wiktorCzechowski8127/MilitaryGamesTimer/media/doc_media/doc1_download.jpg

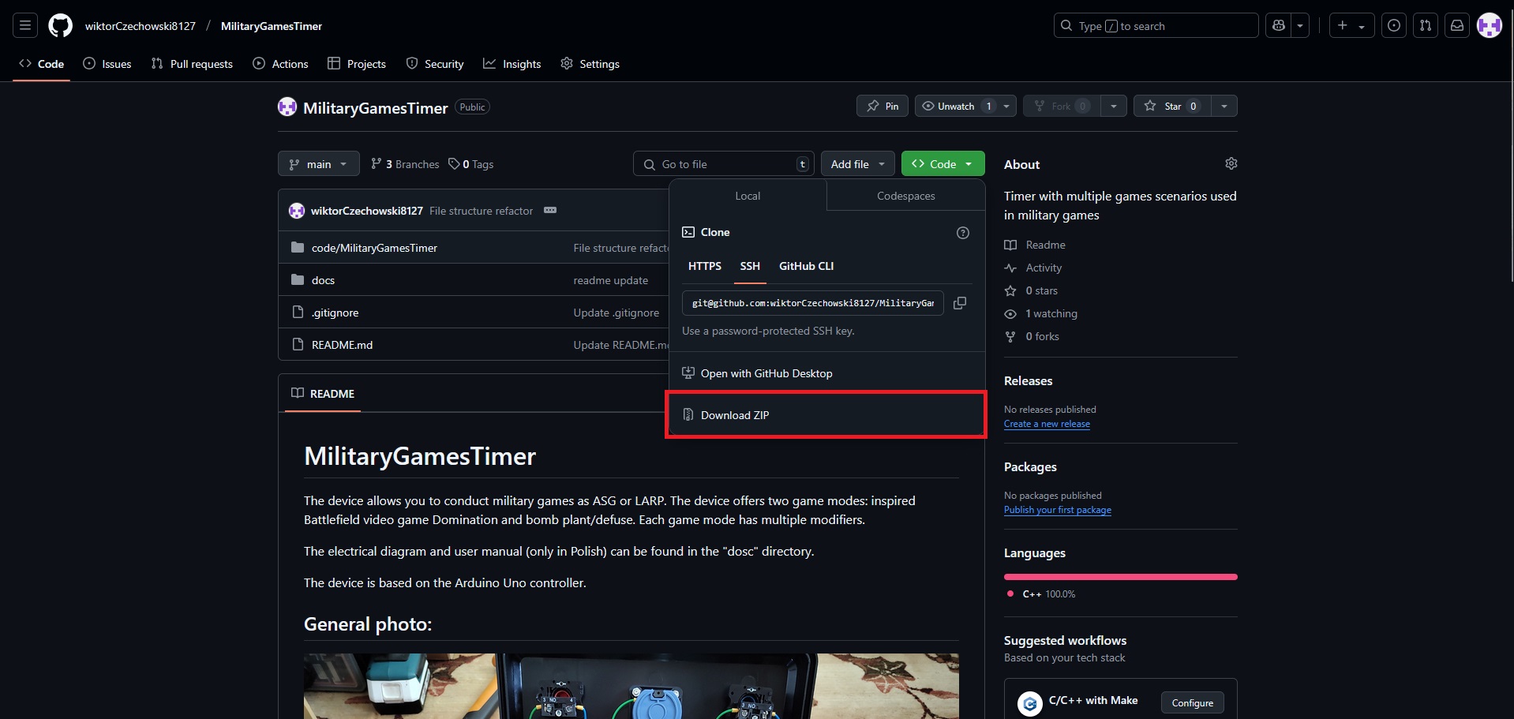
media/doc_media/doc1_download.jpg
