wiktorCzechowski8127/MilitaryGamesTimer/media/doc_media/doc2_idePresentation.jpg

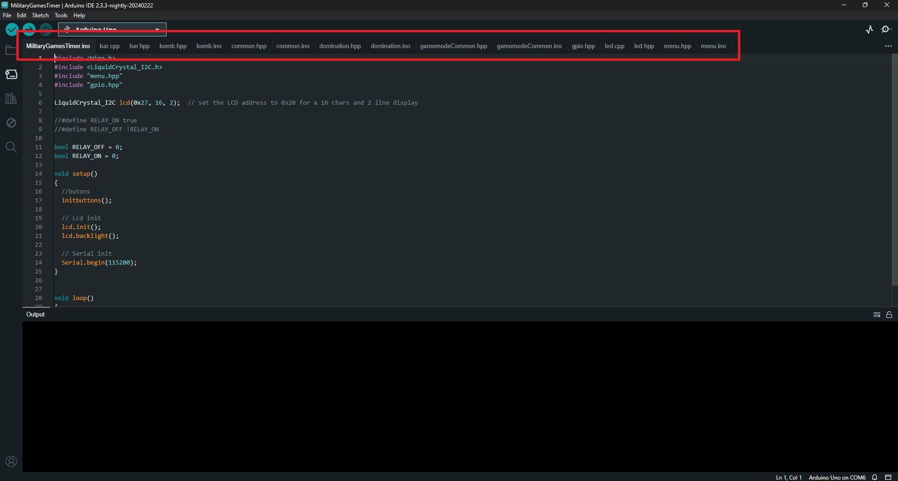
media/doc_media/doc2_idePresentation.jpg
