wiktorCzechowski8127/MilitaryGamesTimer/media/doc_media/doc3_boardSelection.jpg

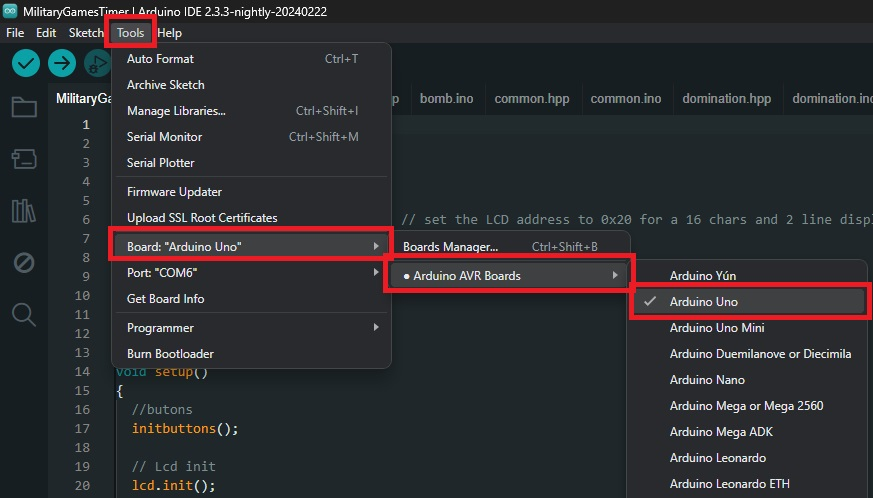
media/doc_media/doc3_boardSelection.jpg
