wiktorCzechowski8127/MilitaryGamesTimer/media/doc_media/doc4_portSelection.jpg

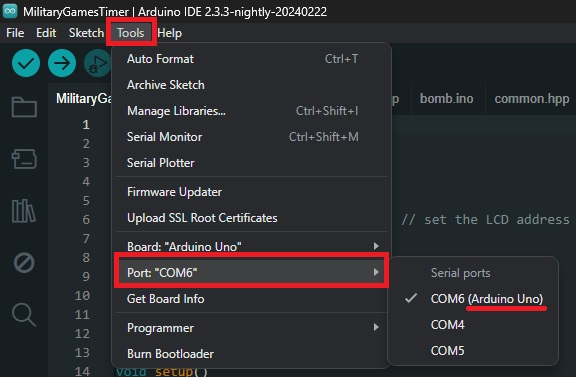
media/doc_media/doc4_portSelection.jpg
