wiktorCzechowski8127/MilitaryGamesTimer/media/doc_media/doc5_upload.jpg

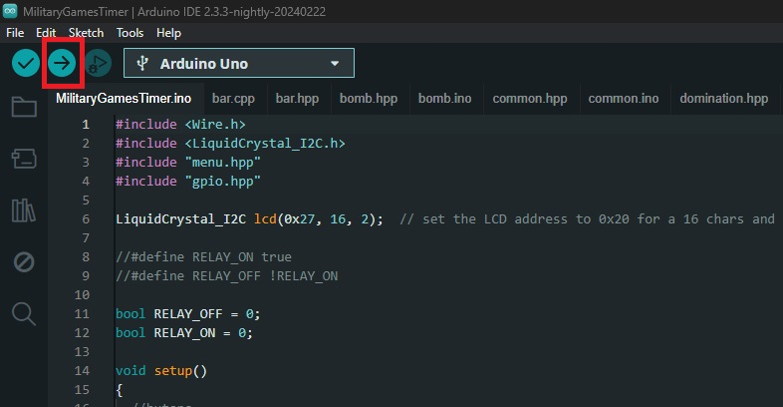
media/doc_media/doc5_upload.jpg
