wiktorCzechowski8127/MilitaryGamesTimer/media/doc_media/doc6_final.jpg

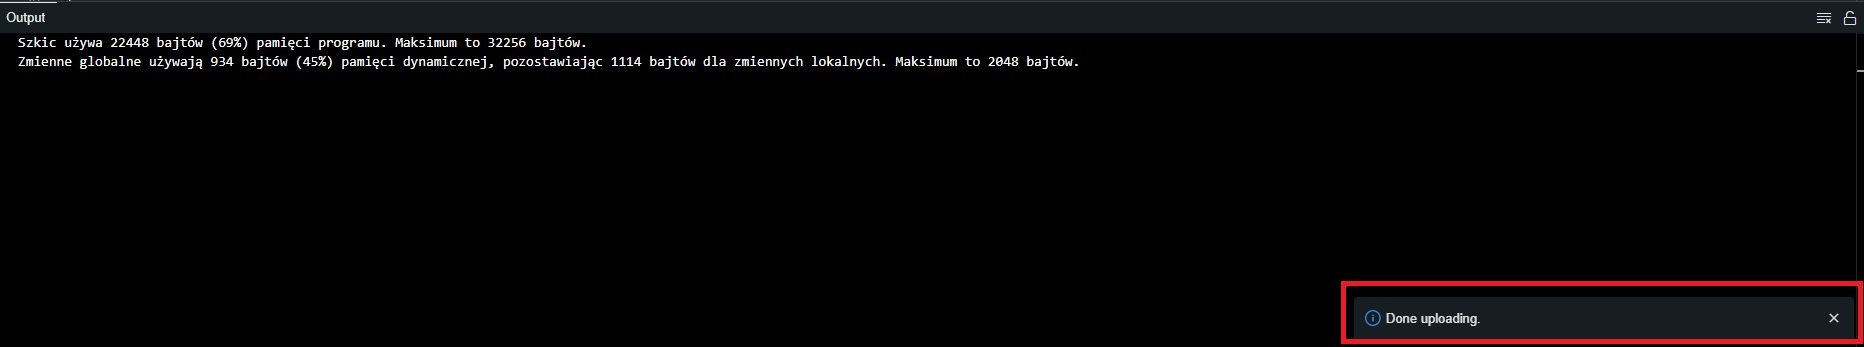
media/doc_media/doc6_final.jpg
