wiktorCzechowski8127/MilitaryGamesTimer/docs/MilitaryGameTimerInstructionPL.pdf

Ostatnia modyfikacja 09.02.2025

# MASZYNA LICZĄCA DO GIER MILITARNYCH

## Autor: Wiktor Czechowski

email: wiktor.czechowski.ti@gmail.com

github: https://github.com/wiktorCzechowski8127/MilitaryGamesTimer
Link do pobrania programu: LINK (https://github.com/wiktorCzechowski8127/MilitaryGamesTimer/archive/refs/heads/main.zip)

### Aktualna wersja dokumentacji nie posiada opisu funkcji

opóźnionego startu, aktualizacja w trakcie przygotowań.

# 1. Uwagi

Jeżeli syrena odziała od momentu uruchomienia układu, należy zewrzeć styki A0 i A1 sterownika i zresetować urządzenia. Więcej informacji w akapicie: Przekaźnik.

# 2. Sugerowane komponenty

Podane linki stanowią jedynie sugestię w jakie komponenty należy się zaopatrzyć. Możliwe jest dowolna zmiana podzespołów pod warunkiem, że działają w tym samym standardzie. Przyciski i przełączniki mogą przybierać różne formy.

Lp. | Nazwa | Komentarz | Link
1. | Arduino Uno R3 | Kupno “klona” arduino pozwoli mocno zredukować koszty. Klony nie naruszają licencji, niektóre marki jak DFRobot oferują jakość oryginału lepszej cenie. Najtańsze chińskie klony często mają nierówno przylutowane porty jednak swoim działaniem nie różnią się od oryginału. W przypadku chińskich klonów odradzam kupowania produktów z konwerterem CH340. Układ ten ma problem z kompatybilnością z Arduino IDE i wgranie programu na sterownik, może wymagać zainstalowania sterowników z zewnętrznych źródeł. Gwarancją poprawnego działania będzie sterownik z konwerterem opartym na układzie Atmel Mega16U2. | Oryginalne arduino (https://botland.com.pl/arduino-seria-podstawowa-oryginalne-plytki/1060-arduino-uno-rev3-a000066-7630049200050.html) Droższy klon bardzo dobrej jakości (https://botland.com.pl/plytki-zgodne-z-arduino-dfrobot/2683-dfrduino-uno-v3-kompatybilny-z-arduino-6959420900015.html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) Tani klon (https://nettigo.pl/products/klon-arduino-uno-r3-atmega328p-mega16u2)
2. | Bateria | Bateria o napięciu wyjściowym 7-12V. | Link (https://botland.com.pl/akumulatory-li-pol-3s-111v-/1307-pakiet-li-pol-redox-700mah-20c-3s-111v-5903754000454.html)
3. | Stabilizator liniowy | Min. 250 mA maksymalnego prądu, zalecane 1A. | Link (https://botland.com.pl/regulatory-napiecia/81-stabilizator-5v-l7805abv-tht-to220-5904422307202.html)
4. Wyświetlacz Lcd | 16x2 | Sterownik zgodny z HD44780 | Wersja bez konwertera (https://botland.com.pl/wyswietlacze-alfanumeryczne-i-graficzne/19732-wyswietlacz-lcd-2x16-znakow-niebieski-ze-zlaczami-justpi-5903351243131.html) Wersja z konwerterem (https://botland.com.pl/wyswietlacze-alfanumeryczne-i-graficzne/2351-wyswietlacz-lcd-2x16-znakow-niebieski-konwerter-i2c-lcm1602-5904422309244.html)
5. Konwerter I2C do | wyświetlacza lcd | Dostępne są wyświetlacze lcd z wlutowanym konwerterem i2c. | Link (https://botland.com.pl/konwertery-pozostale/2352-konwerter-i2c-dla-wyswietlacza-lcd-hd44780-5903351248693.html)
6. | Moduł przekaźnika | Należy upewnić się czy moduł zwiera styki wejścia “NO” gdy na pin “In” podawany jest stan wysoki czy stan niski. Obydwa rodzaje przekaźników będą działały poprawnie jednak w wypadku tego drugiego konieczne będzie zwarcie ze sobą pinów A0 i A1 sterownika. | Link (https://botland.com.pl/przekazniki-przekazniki-arduino/8463-modul-przekaznika-1-kanal-styki-10a250vac-cewka-5v-5904422300517.html)
7. Przełącznik | dźwigniowy | Dostępne jest wiele modeli. | Link (https://electro24.pl/Lacznik-Krzywkowy-16A-0-1-1F-Tablicowy-Ip65)
8. | Przyciski NO | Dostępne jest wiele modeli. Najczęściej duże, czerwone przyciski sterownicze są przyciskami NC które nie będą poprawnie współpracowały z urządzeniem. | Przyciski gry (https://electro24.pl/pl/p/Przycisk-Sterowniczy-Niebieski-Xb2-Ea61-Fi22/8545) Przyciski menu (https://botland.com.pl/tact-switch/11197-tact-switch-12x12mm-z-nasadka-grzybek-zolty-5szt-5904422307516.html)

| | Sugerowany produkt posiada wymienny moduł: LINK. (https://electro24.pl/Styk-Pomocniczy-Zwierny-No-Xb2-Be101-Zielony)
9. | Diody led | Do prawidłowego podłączenia diod potrzebne będą 2 rezystory 50 i 100 ohm. | Link (https://botland.com.pl/diody-led/19991-dioda-led-5mm-niebieska-10szt-justpi-5904422328795.html)
10. | Buzzer | Wymagane napięcie zasilania 5V. | Link (https://botland.com.pl/buzzery-generatory-dzwieku/786-buzzer-z-generatorem-5v-12mm-tht-5904422366940.html)
11. | Syrena | Napięcie zasilania dostosowane do posiadanej baterii. Zalecane 7-12V. | Link (https://botland.com.pl/syreny-alarmowe/3040-syrena-alarmowa-s2-6-14v-105db-6-tonow-5900804011804.html)

Ostatni dostęp: 23.04.2024

# 3. Schemat elektryczny

Schemat w wyższej rozdzielczości dostępny pod linkiem: LINK. (https://github.com/wiktorCzechowski8127/MilitaryGamesTimer/tree/main/docs)

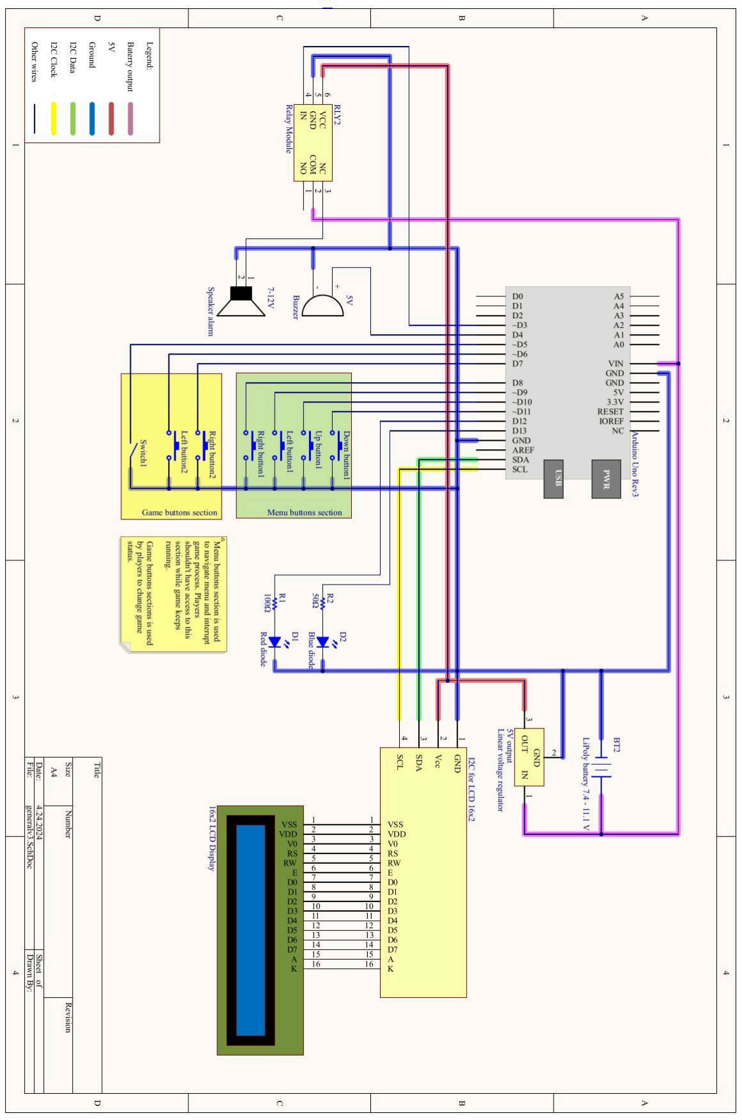
[picture p8: figure]

# 4. Opis oprogramowania

## 4.1. Opis manipulatorów

### - Nawigacja w menu

Nawigacja w menu odbywa się za pomocą 4 przycisków.

Nawigacja w ramach funkcji: Ustaw czas, Ustaw wartość jest nieco inna, szczegóły w opisie poszczególnych funkcji.

### - Sterowanie w grze

Sterowanie w grze odbywa się za pomocą dwóch przycisków, przełącznika oraz dwóch przycisków menu pełniących rolę moderatorskie.

Pin sterownika | Przycisk nawigacji | Funkcja
D8 | MENU_PRAWO | Następna opcja
D9 | MENU_LEWO | Poprzednia opcja
D10 | MENU_GÓRA | Powrót
D11 | MENU_DÓŁ | Akceptacja
Pin sterownika | Przycisk gry | Funkcja
D7 | GRA_PRAWY | Przejmowanie punktu (więcej szczegółów w opisach poszczególnych trybów gry).
D6 | GRA_LEWY | Przejmowanie punktu (więcej szczegółów w opisach poszczególnych trybów gry).
D5 | GRA_PRZEŁĄCZ NIK | Blokada pozostałych przycisków gry (opcjonalne).
D8 - D9 | MENU_PRAWO oraz MENU_LEWO | Naciśnięcie i przytrzymanie tych przycisków przez 3 sekundy powoduje: ● Zakończenie gry ● Wyłączenie syreny po zakończeniu gry ● Wyjście z podsumowania gry do menu Gracze nie powinni mieć dostępu do tych przycisków w trakcie rozgrywki.

## 4.2. Wybór trybu gry - menu etap 1

Lp. | Tryb gry | Opis
1. | Bomba | Uzbrojenie bomby zanim przybędą posiłki i utrzymanie bomby przez czas potrzeby do inicjalizacji wybuchu.
2. | Dominacja | Przejęcie i utrzymanie punktu.

Użycie przycisków MENU_PRAWO i MENU_LEWO pozwala wybrać tryb gry. Przycisk MENU_DÓŁ przenosi do menu związanego z wybranym trybem gry.

## 4.3. Tryby rozgrywki - menu etap 2

### 4.3.1. Tryb bomby

- Opis rozgrywki
Ilość drużyn: 2 (broniąca, atakująca)
Celem drużyny broniącej niedopuszczenie do uzbrojenia bomby przez czas zdefiniowany w polu CZAS GRY. Jeżeli po zakończeniu tego czasu bomba pozostanie nieuzbrojona, wygrywa drużyna broniąca. Jeżeli po zakończeniu tego czasu bomba będzie uzbrojona gra kończy się dopiero w momencie doprowadzenia do wybuch lub rozbrojenu bomby.
Celem drużyny atakującej jest uzbrojenie bomby oraz utrzymanie tego stanu przez CZAS WYBUCHU. Jeżeli po zakończeniu tego czasu bomba pozostanie uzbrojona, wygrywa drużyna atakująca.
Uzbrajanie i rozbrajanie bomby odbywa się poprzez naciśnięcie i przytrzymanie GRA_PRAWY i GRA_LEWY przycisku gry przez czas określany jako UZBRAJANIE lub ROZBRAJANIE.
- Dostępne modyfikatory
Lp. | Pozycja | Funkcja | Opis | Limity
1. | CZAS GRY | Ustaw czas | Czas do przybycia posiłków. Ustawienie czasu jako 0 spowoduje usunięcie z gry motywu przybycia posiłków.
2. CZAS | WYBUCHU | Ustaw czas | Czas do wybuchu bomby.
3. | UZBRAJANIE | Ustaw czas | Czas potrzebny do uzbrojenia bomby.

4. | ROZBRAJANIE | Ustaw czas | Czas potrzebny do rozbrojenia bomby.
5. | PRZEŁĄCZNIK | TAK/NIE | TAK: Ustawienie GRA_PRZEŁĄCZNIK w pozycji “0” blokuje możliwość korzystania z przycisków gry. NIE: Pozycja GRA_PRZEŁĄCZNIK nie ma wpływu działanie przycisków gry.
6. ROZ. KONCZY | (Rozbrojenie kończy grę) | TAK/NIE | Pierwsze rozbrojenie kończy grę z drużyną broniącą jako zwycięzca.
7. RES.CZAS.EK | S (Reset czasu eksplozji) | TAK/NIE | Czas potrzebny do wybuchu po każdym uzbrojeniu liczony jest od nowa.
8. COFANIE | PROG. (Cofanie progresu) | TAK/NIE | Zaprzestanie uzbrajania lub rozbrajania powoduje cofanie progresu operacji w identycznym tempie.
9. | SYRENA | Ustaw czas | Długość działania syrenu po zakońćzeniu gry.
10. | HISTORIA | Historia | Wyświetlanie wyników 3 ostatnich rozgrywek.
11. | Start | Start | Naciśnięcie i przytrzymanie przez 3 sekundy przycisku MENU_DÓŁ uruchamia wybrany tryb gry.

- Interfejs gry

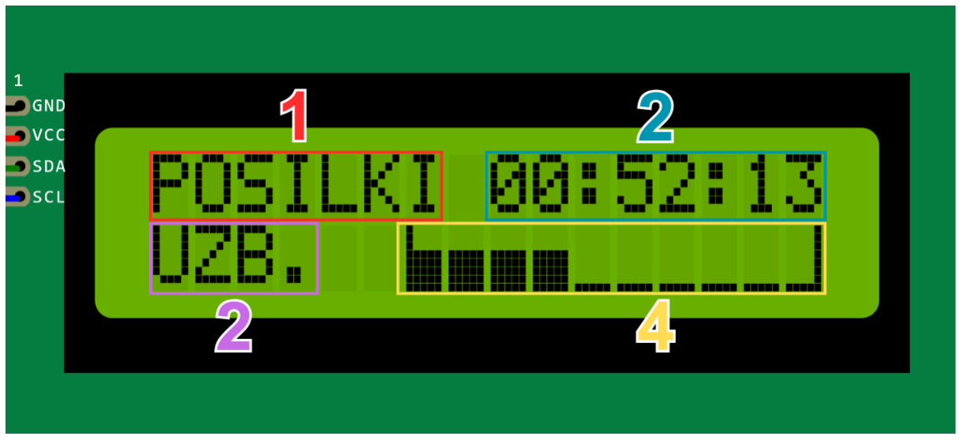
[picture p9: figure]

1. Aktualny status zegara.
POSIŁKI - czas przybycia posiłków WYBUCH - czas do wybuchu bomby.
2. Czas do wystąpienia akcji opisanej w punkcie 1.
3. Aktualnie wykonywana operacja na bombie: UZB. - uzbrajanie,
ROZ. - rozbrajanie.
4. Progress wykonywanej operacji.
- Sygnały świetlne
Led | Sposób działania | Informacja
Czerwony | Praca ciągła | Bomba uzbrojona.
| Mruganie | Uzbrajanie bomby.
Niebieski | Praca ciągła | Bomba rozbrojona.
| Mruganie | Rozbrajanie bomby.

- Podsumowanie

Po zakończeniu rozgrywki wyświetlone zostanie podsumowanie:

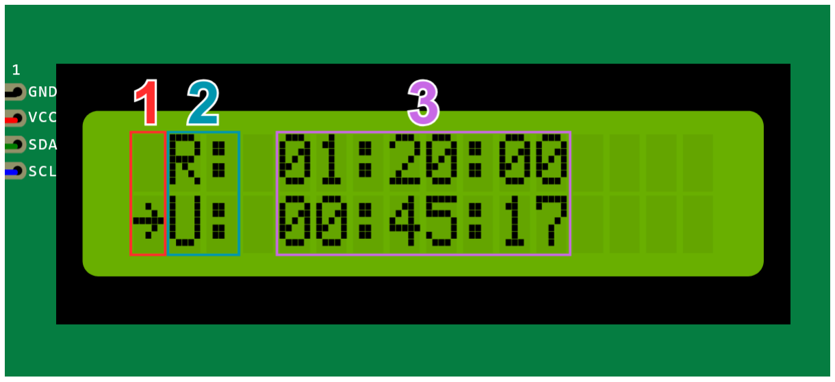
[picture p10: figure]

1. Oznaczenie wygranej: strzałka wskazuje na drużynę, która wygrała.
2. Oznaczenie statusu bomby:
R - Rozbrojona,
U - Uzbrojona.
3. Łączny czas statusu jaki posiadała bomba w trakcie całej rozgrywki.

### 4.3.2. Tryb dominacji

- Opis rozgrywki
Ilość drużyn: 2 (atakująca, atakująca)
Tryb gry wzorowany na trybie “Dominacja” występującym w grach z serii Battlefield. Celem każdej z drużyn jest zdobycie i utrzymanie punktu. Przejmowanie punktu odbywa się za pomocą naciśnięcia i przytrzymanie przez czas określony w parametrach PRZEJECIE i P.PRZEJECIE, przycisku (w zależności od podziału drużyn) GRA_LEWY lub GRA_PRAWY. Posiadanie punkt przez czas określony w parametrze PUNKT CO generuje punkt zwycięstwa.
Zdobycie przez którąś z drużyn punktów zwycięstwa w liczbie określonej przez parametr LIMIT PKT kończy grę. Alternatywnym zakończeniem gry jest upływ czasu CZAS GRY, zwyciężą wtedy drużyna posiadająca większą ilość punktów zwycięstwa.
- Dostępne modyfikatory
Lp. | Pozycja | Funkcja | Opis | Limity
1. | CZAS GRY | Ustaw czas | Maksymalny czas gry. Ustawienie wartości 0 uruchomi grę w trybie nielimitowanego czasu. Zegar będzie wyświetlał czas który upłynął od startu.
2. P. PRZEJECIE | (Pełne przejęcie) | Ustaw czas | Maksymalny przez jaki można przejmować punkt. Osiągnięcie tego czasu nie daje dodatkowych korzyści w punktach, jedynie wydłuża czas przejmowania punktu drużynie przeciwnej. Możliwe jest ustawienie identycznych wartości dla P.PRZEJECIE i PRZEJECIE.
3. | PRZEJECIE | Ustaw czas | Czas przez który należy przytrzymać przycisk aby doprowadzić do rozpocząć procedurę zdobywania punktów.
4. | PUNKT CO | Ustaw wartość | Czas który punkt musi być przejęty aby otrzymać punkt zwycięstwa.

5. LIMIT | PUNKOW | Ustaw wartość | Ilość punktów który należy zdobyć aby wygrać rozrywkę.
6. | PRZELACZNIK | TAK/NIE | TAK: Ustawienie GRA_PRZEŁĄCZNIK w określonej pozycji blokuje możliwość korzystania z przycisków gry. NIE: Pozycja GRA_PRZEŁĄCZNIK nie ma wpływu działąnie przycisków gry.
7. | SYRENA | Ustaw czas | Długość działania syrenu po zakońćzeniu gry poprzez doprowadzenia do wybuchu lub przybycia posiłków.
8. | HISTORIA | Historia | Wyświetlanie wyników 3 ostatnich rozgrywek.
9. | Start | Start | Naciśnięcie i przytrzymanie przez 3 sekundy przycisków MENU_PRAWY i MENU_LEWY uruchamia wybrany tryb gry.
- Interfejs gry

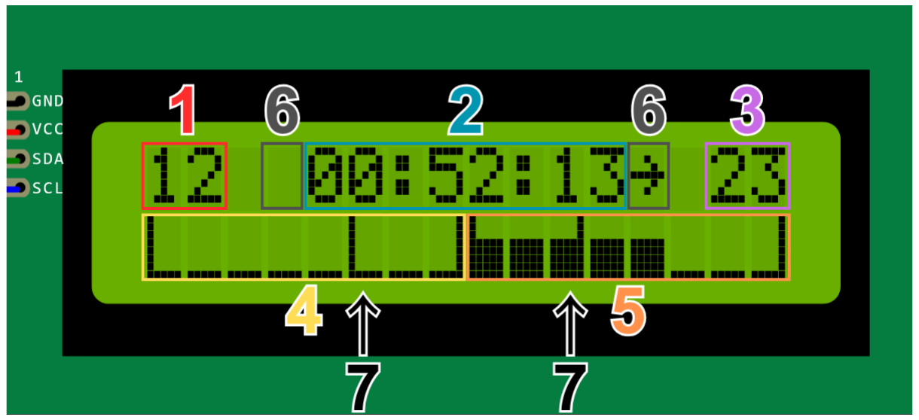
[picture p11: figure]

1. Ilość punktów zdobytych przez drużynę z przyciskiem po lewej stronie.
2. Czas do zakończenia gry.
3. Ilość punktów zdobytych przez drużynę z przyciskiem po prawej stronie.

4. Progres przejęcia punktu przez drużynę z przyciskiem po lewej stronie.
5. Progres przejęcia punktu przez drużynę z przyciskiem po prawej stronie.
6. Znacznik przejmowania punktu.
7. Znacznik określający moment przejęcia punktu, jeżeli go nie ma oznacza to, że przejęcie punktu jest równoznaczne z pełnym przejęciem.
- Sygnały świetlne
Led | Sposób działania | Informacja
Czerwony | Praca ciągła | Pełne przejęcie punktu przez drużynę z przyciskiem po lewej stronie.
| Mruganie | Przejęcie punktu przez drużynę z przyciskiem po lewej stronie.
Niebieski | Praca ciągła | Pełne przejęcie punktu przez drużynę z przyciskiem po prawej stronie.
| Mruganie | Przejęcie punktu przez drużynę z przyciskiem po prawej stronie.
Brak | | Punkt nie przejęty.
- Podsumowanie
Po zakończeniu rozgrywki wyświetlone zostanie podsumowanie:

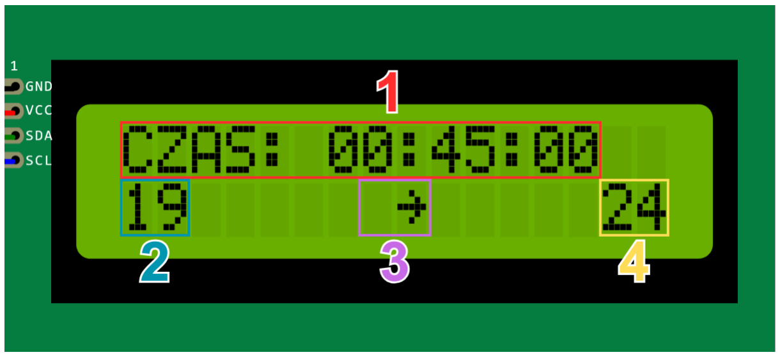
[picture p12: figure]

1. Łączny czas gry.
2. Ilość punktów zdobytych przez drużynę z przyciskiem po lewej stronie.
3. Znacznik zwycięskiej drużyny.
4. Progres przejęcia punktu przez drużynę z przyciskiem po prawej stronie.

## 4.4. Funkcje menu

### 4.4.1. Ustaw czas

Umożliwia ustawienie wartości związanej z czasem.
Użycie przycisków MENU_LEWO oraz MENU_PRAWO pozwala ustawić kursor na odpowiedniej pozycji. Wyjście kursorem poza wartość akceptuje wynik i przenosi do menu. Użycie przycisków MENU_GÓRA oraz MENU_DÓŁ pozwala ustawić wartość pod kursorem.

### 4.4.2. Ustaw wartość

Umożliwia ustawienie wartości związanej z liczbą rzeczywistą.
Użycie przycisków MENU_LEWO oraz MENU_PRAWO pozwala ustawić kursor na odpowiedniej pozycji. Wyjście kursorem poza wartość akceptuje wynik i przenosi do menu. Użycie przycisków MENU_GÓRA oraz MENU_DÓŁ pozwala ustawić wartość pod kursorem.

### 4.4.3. TAK/NIE

Pozwala wybrać z opcji tak lub nie.
Użycie przycisków MENU_LEWO oraz MENU_PRAWO pozwala zmienić wybraną opcję.
Użycie przycisków MENU_GÓRA akceptuje wynik i przenosi do menu.

### 4.4.4. Historia

Pozwala wyświetlić 3 ostatnie wyniki rozgrywki. Użycie przycisków MENU_LEWO oraz MENU_PRAWO rozgrywkę której wynik jest wyświetlany.
Użycie przycisków MENU_GÓRA przenosi do menu.
W prawym górnym roku zawsze wyświetlana jest informacja o rozgrywce której wynik jest wyświetlany. Im starsza rozgrywka tym większy wyświetlany numer.

### 4.4.5. Start

Przytrzymanie MENU_DÓŁ przez 3 sekundy uruchamia grę.

# 5. Komentarz

### - Przekaźnik

Na rynku dostępne są dwa popularne rodzaje modułów z przełącznikiem: sterowane napięcie 5V lub sterowane masą. Jeżeli użyty przekaźnik sterowany jest masą należy zewrzeć ze sobą piny A0 i A1 a następnie zresetować urządzenie. Alternatywną opcją jest podłączenie syreny do wejścia NO przekaźnika, jednak w tym wypadku wzrośnie zużycie baterii. W przeciwnym wypadku syrena będzie pracowała od momentu podłączenia układu do prądu.

### - Bateria

Bezpośrednio z baterii zasilane są 2 urządzenia: sterownik oraz syrena. Arduino wymaga zasilania w zakresie 7-12V. Dobrym wyborem mogą być akumulatory lipo 7.4 lub
11.1. Należy pamiętać aby dobrać syrenę współpracującą napięciowo z baterią. Do zasilania pozostałych urządzeń wykorzystywany jest stabilizator liniowy.

### - Instalacja oprogramowania

1. Pobierz i zainstaluj środowisko programistyczne Arduino IDE (link). (https://www.arduino.cc/en/software)
2. Podłącz płytkę Arduino do komputera za pomocą przewodu USB.
3. Pobierz kod z repozytorium (link). (https://github.com/wiktorCzechowski8127/MilitaryGamesTimer)

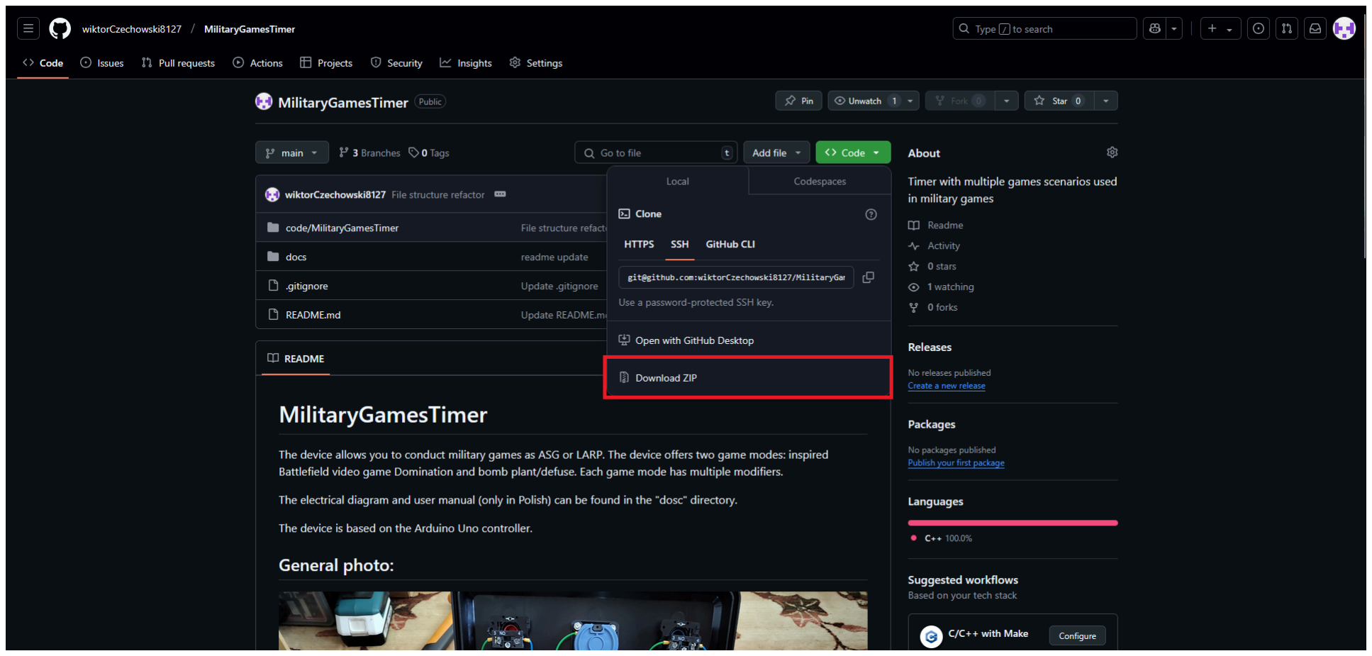
[picture p13: figure]

(link (https://github.com/wiktorCzechowski8127/MilitaryGamesTimer/blob/main/media/doc_media/doc1_download.jpg) do zdjęcia w dużej rozdzielczości)

4. Wypakuj pobrane repozytorium i przejdź do folderu code/MilitaryGamesTimer
5. Kliknij dwukrotnie na plik MilitaryGamesTimer.ino. Uruchomione zostanie środowisko programistyczne a w górnej części powinny być widoczne wszystkie pliki znajdujące się w w.w folderze.

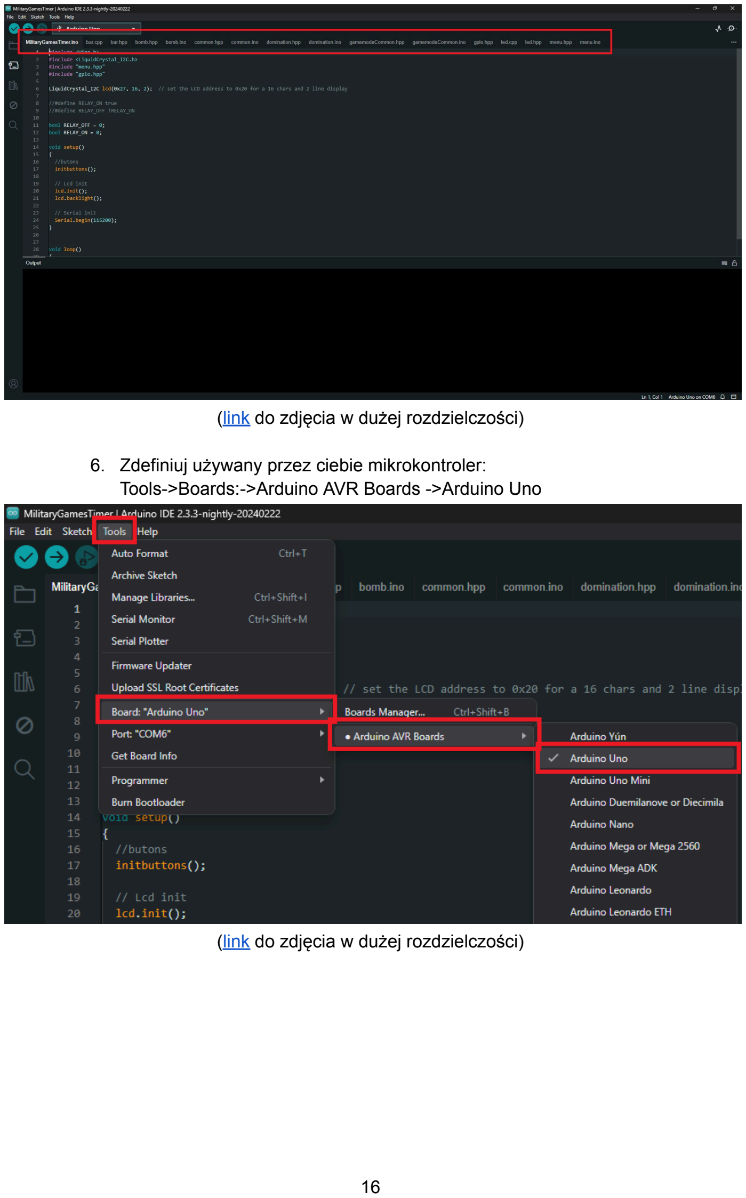
[picture p14: page 16]

(link (https://github.com/wiktorCzechowski8127/MilitaryGamesTimer/blob/main/media/doc_media/doc2_idePresentation.jpg) do zdjęcia w dużej rozdzielczości)

6. Zdefiniuj używany przez ciebie mikrokontroler: Tools->Boards:->Arduino AVR Boards ->Arduino Uno

(link (https://github.com/wiktorCzechowski8127/MilitaryGamesTimer/blob/main/media/doc_media/doc3_boardSelection.jpg) do zdjęcia w dużej rozdzielczości)

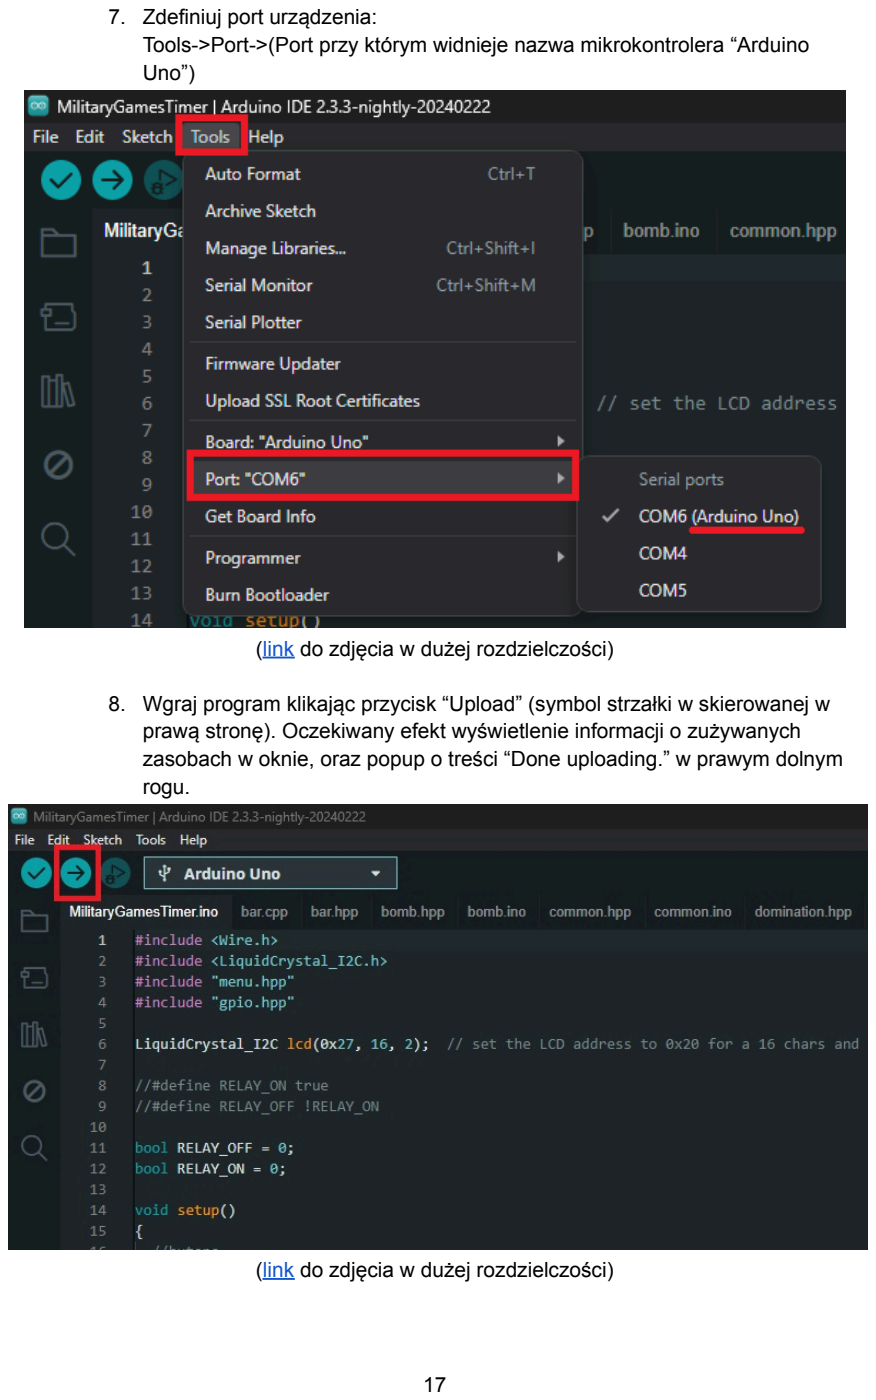
[picture p15: page 17]

7. Zdefiniuj port urządzenia:
Tools->Port->(Port przy którym widnieje nazwa mikrokontrolera “Arduino Uno”)

(link (https://github.com/wiktorCzechowski8127/MilitaryGamesTimer/blob/main/media/doc_media/doc4_portSelection.jpg) do zdjęcia w dużej rozdzielczości)

8. Wgraj program klikając przycisk “Upload” (symbol strzałki w skierowanej w prawą stronę). Oczekiwany efekt wyświetlenie informacji o zużywanych zasobach w oknie, oraz popup o treści “Done uploading.” w prawym dolnym rogu.

(link (https://github.com/wiktorCzechowski8127/MilitaryGamesTimer/blob/main/media/doc_media/doc5_upload.jpg) do zdjęcia w dużej rozdzielczości)

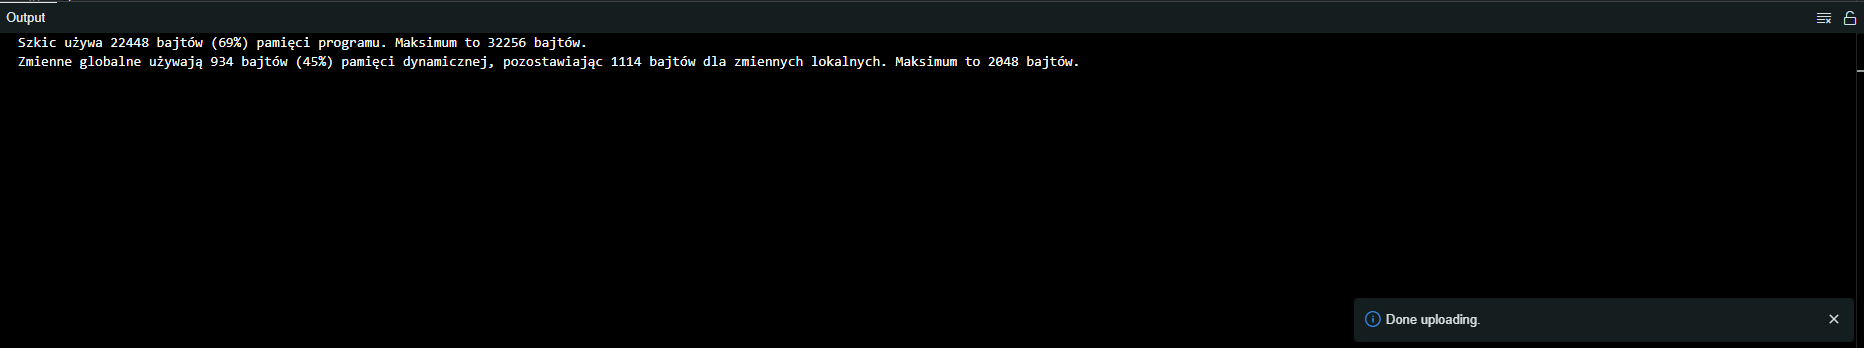
[picture p16: figure]

(link (https://github.com/wiktorCzechowski8127/MilitaryGamesTimer/blob/main/media/doc_media/doc6_final.jpg) do zdjęcia w dużej rozdzielczości)

# 6. Budowa urządzenia

Rozdział nie ma na celu przedstawienia dokładnych instrukcji budowy urządzenia a jedynie pobieżne opisanie mojego jego pomysłu końcową formę.

## 6.1. Przykładowe urządzenie

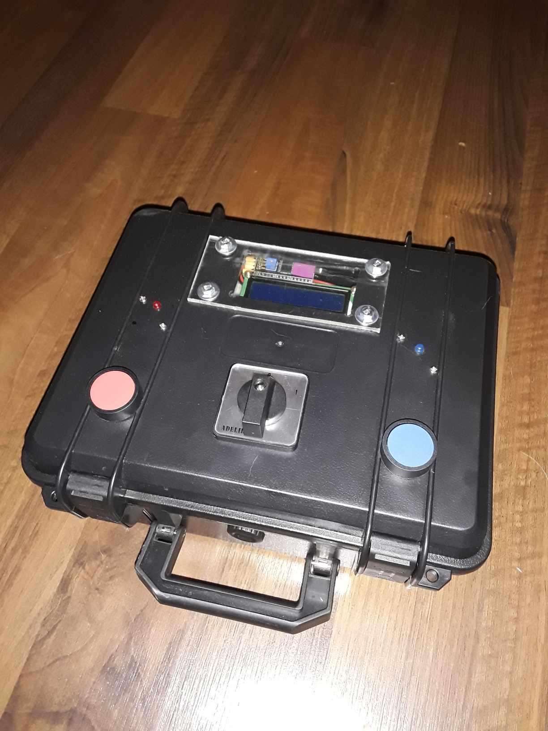
[picture p17: figure]

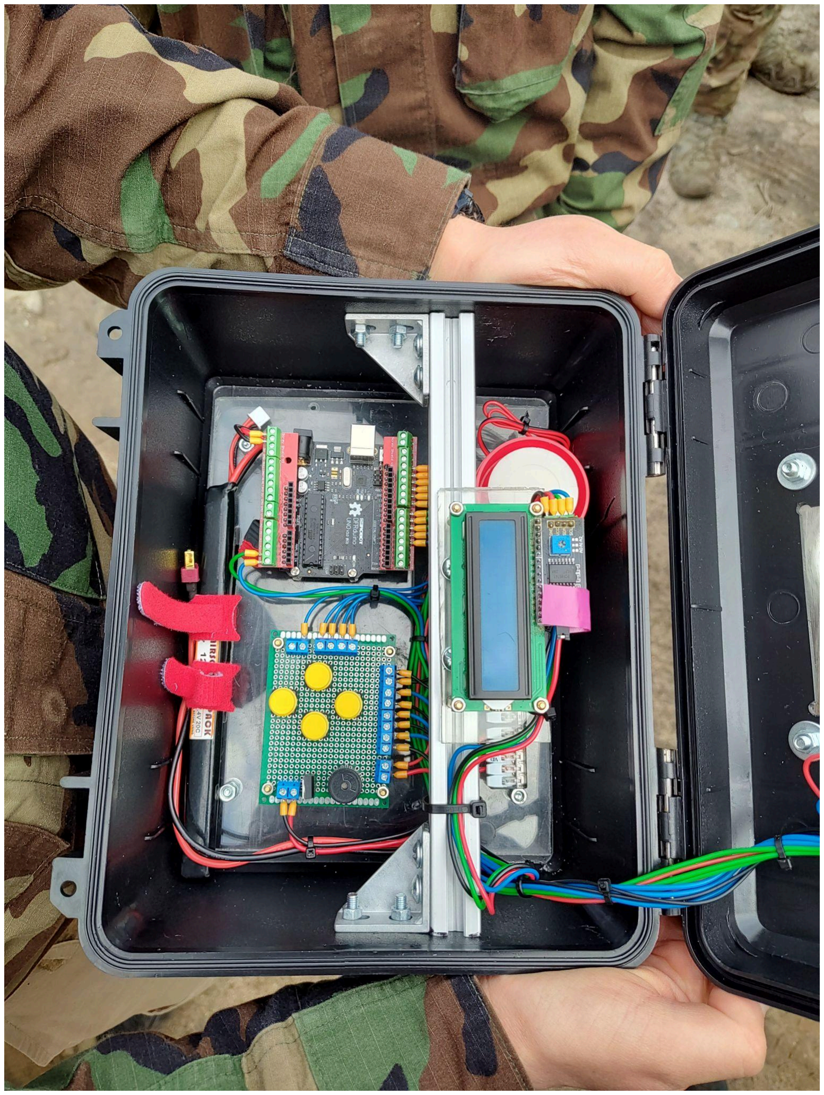
[picture p18: figure]

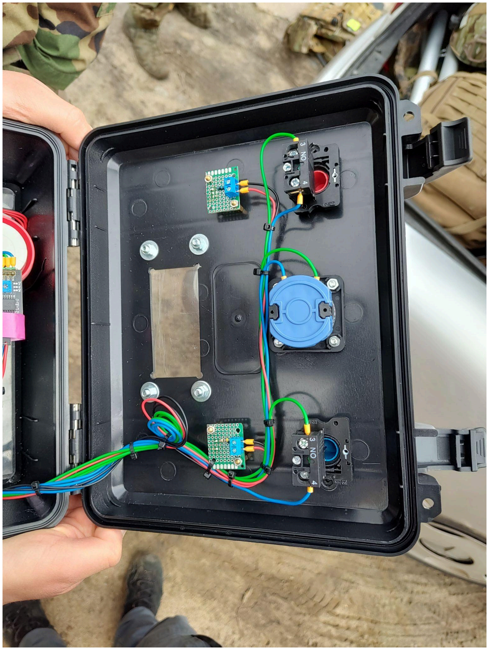
[picture p19: figure]

## 6.2. Komponenty użyte do budowy urządzenia

Lp. | Nazwa | Komentarz | Link
1. Skrzynka | narzędziowa | Wymiary: 280 x 245 x 130mm
2. ScrewShield dla | Arduino Uno R3 | | Link (https://botland.com.pl/arduino-shield-ekspandery-wyprowadzen/5343-screwshield-x2-v2-zlacza-srubowe-nakladka-dla-arduino-5904422359607.html)
3. | Płytka drukowana | 2 sztuki | Link (https://botland.com.pl/plytki-uniwersalne/20272-plytka-drukowana-uniwersalna-dwustronna-60x80mm-5904422380564.html)
4. Tuleje | dystansujące | | Link (https://botland.com.pl/tuleje-dystansowe/22372-zestaw-podkladek-dystansowych-m3-zestaw-e-80szt-justpi-5904422383527.html)
5. | Złącza ARK | raster: 2.54, 5.00 mm | Link (https://botland.com.pl/zlacza-ark/9443-zlacze-ark-raster-254mm-2-pin-10szt-5904422313340.html)
6. Profil aluminiowy | 20x20 | Długość 27x mm Elementy mocujące: LINK, (https://sklep.fleximo.pl/katownik-20x40) LINK (https://sklep.fleximo.pl/nakretka-mloteczkowa-6-M5) | Link (https://sklep.fleximo.pl/profil-aluminiowy-konstrukcyjny-20x20)
7. Rzep do | przewodów | Użyty do stabilizacji baterii | Link (https://botland.com.pl/organizery-do-przewodow/12903-organizer-do-przewodow-rzep-12mm-x-15cm-rozne-kolory-12szt-5901969414639.html)
8. | Przewody + tuleje | 0.25 mm², 0.5 mm², 16AWG
9. Pleksa
10. | Kostka VAGO | 2 sztuki, 5pin - linka
Ostatni dostęp: 23.04.2024

## 6.3. Wykonane czynności

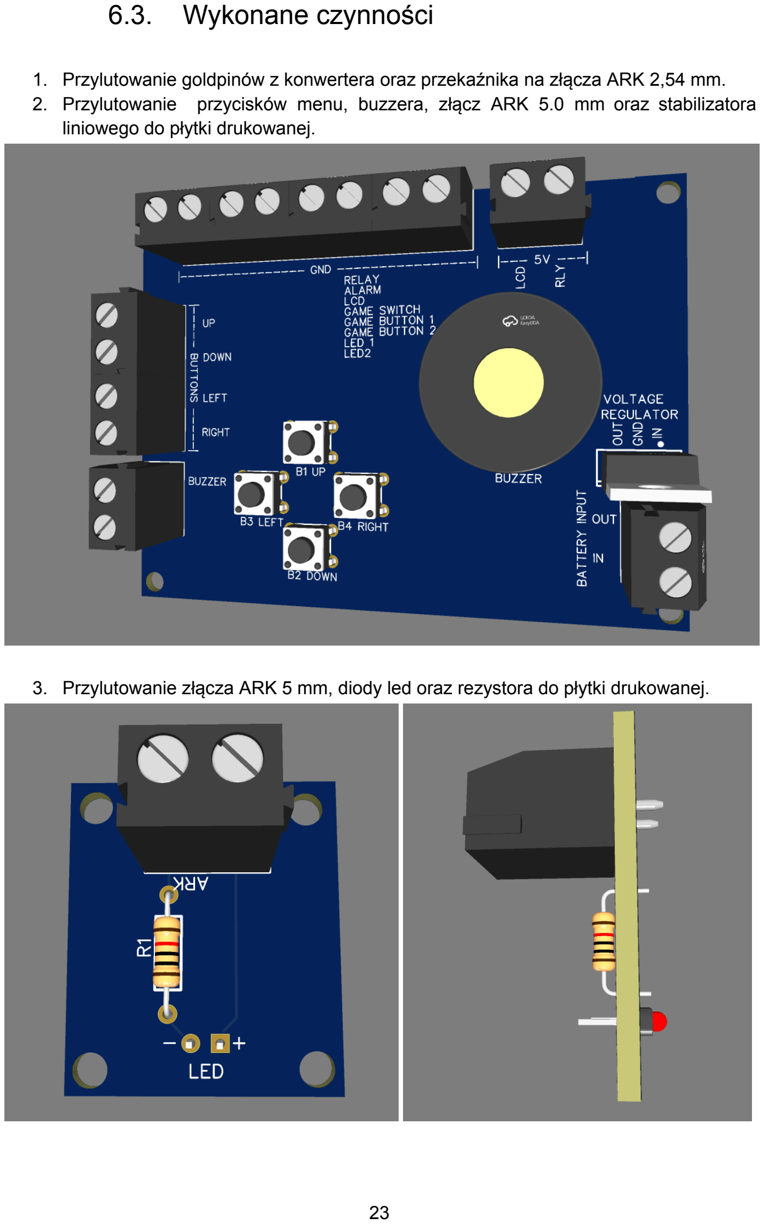
[picture p20: page 23]

1. Przylutowanie goldpinów z konwertera oraz przekaźnika na złącza ARK 2,54 mm.
2. Przylutowanie przycisków menu, buzzera, złącz ARK 5.0 mm oraz stabilizatora liniowego do płytki drukowanej.
3. Przylutowanie złącza ARK 5 mm, diody led oraz rezystora do płytki drukowanej.

4. Umieszczenie przycisków gry, przełącznika oraz płytek z ledami do wieka skrzynki narzędziowej, wycięcie otworu na ekran i zabezpieczenie go pleksą.
5. Przymocowanie: sterownika, płytki z przyciskami menu oraz modułu przekaźnika za pomocą tulei dystansujących do dużego kawałka pleksi oraz przymocowanie syreny alarmowej. Umieszczenie wewnątrz skrzynki narzędziowej pleksi wraz ze wszystkimi elementami.
6. Przymocowanie ekranu lcd do małego kawałka pleksi za pomocą długich tulei dystansujących, przymocowanie całość do aluminiowego profilu, umieszczenie wyświetlacza wraz z profilem w skrzynce narzędziowej.
7. Połączenie wszystkich modułów za pomocą przewodów zwieńczonych rurkami izolowanymi. Elementy zasilane bezpośrednio z baterii połączyć kostkami VAGO.
