wiktorCzechowski8127/MilitaryGamesTimer/docs/militaryGameTimerSchema.pdf

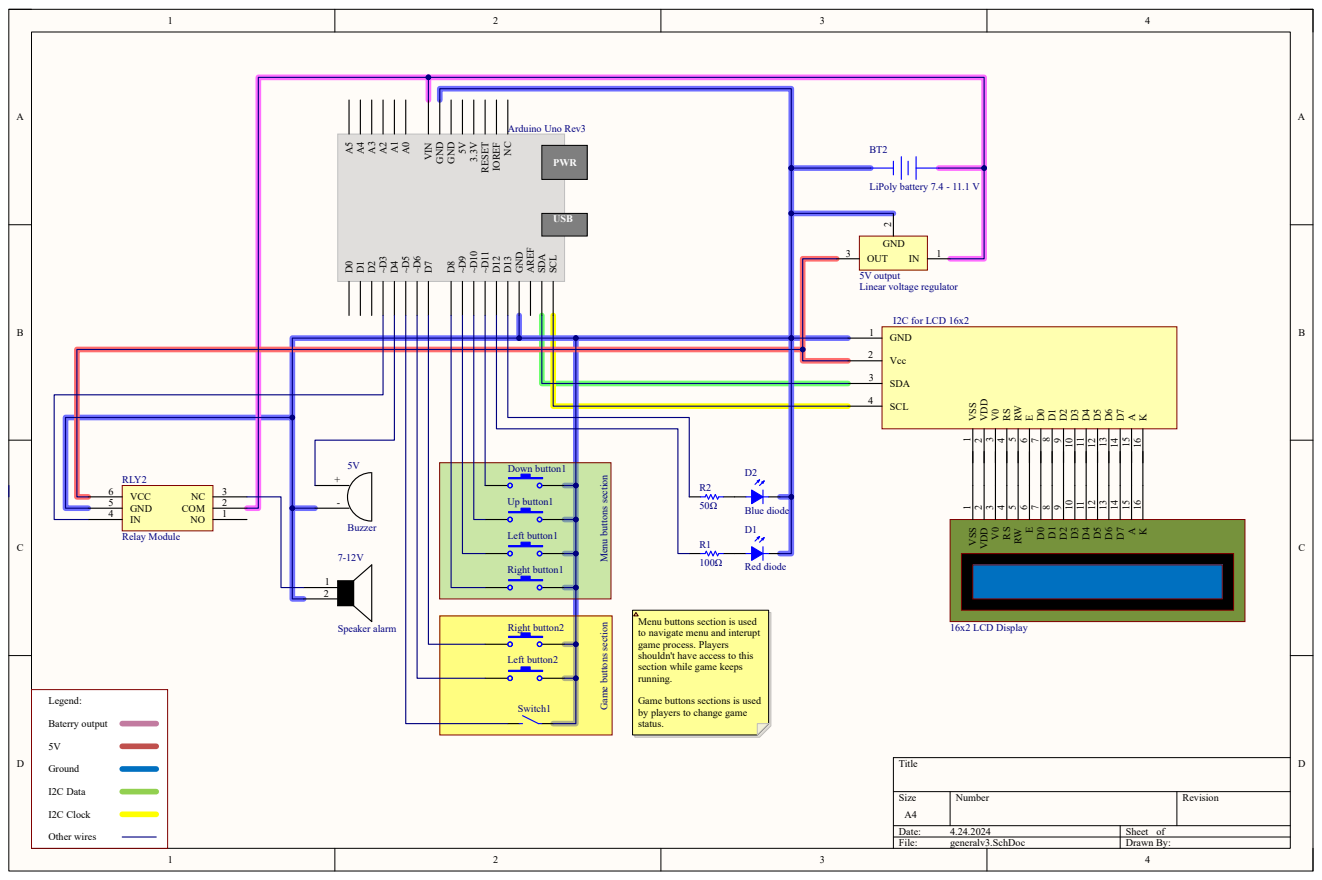
[picture p21: page 1]

Menu buttons section is used
to navigate menu and interupt
game process. Players
shouldn't have access to this
section while game keeps
running.

Game buttons sections is used
by players to change game
status.
