wiktorCzechowski8127/MilitaryGamesTimer/code/MilitaryGamesTimer/menu.ino

#include "menu.hpp"

void startGame(menuBaseS* menuBase)
{
  bool startButtonKeepPushed = false;
  unsigned long pushingTime = 0;
  lcd.clear();
  lcd.setCursor(0,0);
  lcd.print("STARTUJE TRYB");
  lcd.setCursor(0,1);
  if(menuBase->navigation.menuPosition[0] == BOMB_GAMEMODE)
  {
    lcd.print("BOMBY");
  }
  else if(menuBase->navigation.menuPosition[0] == DOMINATION_GAMEMODE)
  {
    lcd.print("DOMINACJI");
  }
  while (true)
  {
    startButtonKeepPushed = false;
    if(buttonPushed(UP_BUTTON))
    {
      //Serial.println("up");
      break;
    }
    if(digitalRead(DOWN_BUTTON) == 0)
    {
      startButtonKeepPushed = true;
      if(pushingTime == 0)
      {
        pushingTime = millis();
      }
    }

    if(startButtonKeepPushed == true)
    {
      if(millis() > (pushingTime + 3000))
      {
        if(menuBase->navigation.menuPosition[0] == BOMB_GAMEMODE)
        {
          processBomb(&menuBase->gamemodeData.gamemodeBomb);
        }
        else if(menuBase->navigation.menuPosition[0] == DOMINATION_GAMEMODE)
        {
          //printGamemodeSettingsOnSerial(&menuBase->gamemodeData.gamemodeDomination);
          processDomination(&menuBase->gamemodeData.gamemodeDomination);
        }     
        menuBase->navigation.menuStage = 0;
        menuBase->navigation.freezeMenu = true;
        break;
      }
      else
      {   
        lcd.setCursor(13,1);
        if(millis() > (pushingTime + 0)) lcd.print(".");
        if(millis() > (pushingTime + 1000)) lcd.print(".");
        if(millis() > (pushingTime + 2000)) lcd.print(".");
      }
    }
    else
    {
      lcd.setCursor(13,1);
      lcd.print("   ");
      pushingTime = 0;
    }
  }
}


/* > Function validateTime
*******************************************************************************/
/**
 * @brief Proceding tresholds on time.
 * 
 * @param[in] time      Time param to procede.
 * @return void
 * 
*******************************************************************************/
void validateTime(humanTimeT* time)
{
    if(*time > 65515) //TODO Uintmax
    {
        *time = 0;
    }
    else if(*time > 60)
    {
        *time = 60;
    }
}

/* > Function setTime
*******************************************************************************/
/**
 * @brief Setting time of gamemode option.
 * 
 * @param[in] timeInMs     Pointer to time in Ms to set.
 * @param[in] minutesOnly  Information about using only minutes and seconds.
 * @param[in] timeLimit    timeToModify limit
 * @return void
 * 
*******************************************************************************/
void setTime(msTimeT* timeToModify, bool minutesOnly, msTimeT timeLimit = UINT32_MAX)
{
  // Initializing variables
  char valueToPrint[15] = "";
  humanTimeT hours;
  humanTimeT minutes;
  humanTimeT seconds;
  convertMsTo3var(timeToModify, &hours, &minutes, &seconds);

  unsigned short cursorPosition = 0;
  unsigned short monthOnlyPositionTreshold = 0;

  bool isButtonPushed = false;
  bool isUpOrDownButtonPused = false;
  short operand = 1;

  // Printing status on lcd
  lcd.clear();
  lcd.setCursor(0,0);
  lcd.print("USTAW CZAS");
  if (minutesOnly)
  {
    cursorPosition = 3;
    monthOnlyPositionTreshold = 3;
    snprintf(valueToPrint, sizeof valueToPrint, "%02d:%02d", minutes, seconds);
  }
  else
  {
    cursorPosition = 0;
    monthOnlyPositionTreshold = 0;
    snprintf(valueToPrint, sizeof valueToPrint, "%02d:%02d:%02d", hours, minutes, seconds);       
  }
  lcd.setCursor(0,1);
  lcd.print(valueToPrint);
  lcd.setCursor(cursorPosition - monthOnlyPositionTreshold,1);
  lcd.blink();

  // Main function loop
  while(true)
  {
    isUpOrDownButtonPused = false;
    isButtonPushed = false;

    // Reading button status
    if(buttonPushed(UP_BUTTON))
    {
      isButtonPushed = true;
      isUpOrDownButtonPused = true;
      operand = 1;
    }
    if(buttonPushed(DOWN_BUTTON))
    {
      isButtonPushed = true;
      isUpOrDownButtonPused = true;
      operand = -1;
    }
    if(buttonPushed(RIGHT_BUTTON))
    {
      isButtonPushed = true;
      cursorPosition++;
      if(cursorPosition == 2 || cursorPosition == 5)
      {
        cursorPosition++;
      }
    }
    if(buttonPushed(LEFT_BUTTON))
    {
      isButtonPushed = true;
      cursorPosition--;
      if(cursorPosition == 2 || cursorPosition == 5)
      {
        cursorPosition--;               
      }
    }

    // Proceding up/down buttons
    if(isUpOrDownButtonPused)
    {
      switch (cursorPosition)
      {
      case HOURS_TENS:
        hours += (TEENS * operand);
        validateTime(&hours);
        break;
      case HOURS_UNITS:
        hours += (UNITS * operand);
        validateTime(&hours);
        break;
      case MINUTES_TENS:
        minutes += (TEENS * operand);
        validateTime(&minutes);
        break;
      case MINUTES_UNITS:
        minutes += (UNITS * operand);
        validateTime(&minutes);
        break;
      case SECONDS_TENS:
        seconds += (TEENS * operand);
        validateTime(&seconds);
        break;
      case SECONDS_UNTIS:
        seconds += (UNITS * operand);
        validateTime(&seconds);
        break;
      default:
        break;
      }
    }

    // Printing status on lcd
    if(isButtonPushed)
    {   
      if (cursorPosition >= TIME_CHARACTERS || cursorPosition < monthOnlyPositionTreshold)
      {
        convert3varToMs(hours, minutes, seconds, timeToModify);
        lcd.noBlink();
        break;
      }

      convert3varToMs(hours, minutes, seconds, timeToModify);
      if(*timeToModify > timeLimit)
      {
        *timeToModify = timeLimit;
        convertMsTo3var(timeToModify, &hours, &minutes, &seconds);
      }

      if (minutesOnly)
      {
        snprintf(valueToPrint, sizeof valueToPrint, "%02d:%02d", minutes, seconds);
      }
      else
      {
        snprintf(valueToPrint, sizeof valueToPrint, "%02d:%02d:%02d", hours, minutes, seconds);       
      }
      lcd.setCursor(0,1);
      lcd.print(valueToPrint);
      lcd.setCursor(cursorPosition - monthOnlyPositionTreshold,1);
      lcd.blink();
    }
  }
}

//TODO fix below.
/* > Function setBoolean
*******************************************************************************/
/**
 * @brief Setting boolean option of gamemode .
 * 
 * @param[in] timeInMs     Pointer to value to set.
 * @param[in] minutesOnly  Value limit.
 * @return void
 * 
*******************************************************************************/
void setBoolean(bool* option)
{
    lcd.clear();
    lcd.setCursor(0,0);
    lcd.print("USTAW STATUS");
    printBoolOption(option);
    lcd.setCursor(BOOL_OPTION_CURSOR_POS,1);

    while(true)
    {
        // Reading button status
        if(buttonPushed(UP_BUTTON))
        {
            break;
        }
        if(buttonPushed(RIGHT_BUTTON))
        {
            *option = !*option; 
            printBoolOption(option);
        }
        if(buttonPushed(LEFT_BUTTON))
        {
            *option = !*option; 
            printBoolOption(option);
        }
    }
}

/* > Function setValue
*******************************************************************************/
/**
 * @brief Setting uint option of gamemode.
 * 
 * @param[in] valueToModify   Pointer to value to set.
 * @param[in] valueLimit      Treshold for valueToModify.
 * @return void
 * 
*******************************************************************************/
void setValue(int* valueToModify, int valueLimit)
{
  unsigned short cursorPosition = 2;

  bool isButtonPushed = false;
  bool isUpOrDownButtonPused = false;
  short operand = 1;

  // Printing status on lcd
  lcd.clear();
  lcd.setCursor(0,0);
  lcd.print("USTAW WARTOSC");
  printValueOption(valueToModify, false);
  lcd.setCursor(cursorPosition,1);
  lcd.blink();

  // Main function loop
  bool processLoop = true;
  while(processLoop)
  {
    isUpOrDownButtonPused = false;
    isButtonPushed = false;

    // Reading button status
    if(buttonPushed(UP_BUTTON))
    {
      isButtonPushed = true;
      isUpOrDownButtonPused = true;
      operand = 1;
    }
    if(buttonPushed(DOWN_BUTTON))
    {
      isButtonPushed = true;
      isUpOrDownButtonPused = true;
      operand = -1;
    }
    if(buttonPushed(RIGHT_BUTTON))
    {
      isButtonPushed = true;
      cursorPosition++;
    }
    if(buttonPushed(LEFT_BUTTON))
    {
      isButtonPushed = true;
      cursorPosition--;
    }

    if((cursorPosition >= 2) && (cursorPosition <= 6))
    {
      // Proceding up/down buttons
      if(isUpOrDownButtonPused)
      {
        //Serial.println(cursorPosition);
        switch (cursorPosition)
        {
        case 2:
          if(*valueToModify > (INT16_MAX - 10000) && (operand == 1))
          {
            *valueToModify = INT16_MAX;
          }
          else
          {
            *valueToModify += (10000 * operand);
          }
          //Serial.println("1: "+ (String)*valueToModify); 
          break;
        case 3:
          *valueToModify += (1000 * operand);
          //Serial.println("2: "+ (String)*valueToModify); 
          break;
        case 4:
          *valueToModify += (100 * operand);
          //Serial.println("3: "+ (String)*valueToModify); 
          break;
        case 5:
          *valueToModify += (10 * operand);
          //Serial.println("4: "+ (String)*valueToModify); 
          break;
        case 6:
          *valueToModify += (1 * operand);
          //Serial.println("5: "+ (String)*valueToModify); 
          break;
        default:
          break;
        }

        if(*valueToModify > valueLimit)
        {
          *valueToModify = valueLimit;
          //Serial.println("limit"); 
        }
        else if(*valueToModify < 0)
        {
          *valueToModify = 0;
          //Serial.println("zero"); 
        }
        //Serial.println(*valueToModify); 
      }
      // Printing status on lcd
      if(isButtonPushed)
      {   
        printValueOption(valueToModify, false);
        lcd.setCursor(cursorPosition,1);
      }
    }
    else
    {
      processLoop = false;
    }
  }
  lcd.noBlink();
}

/* > Function convertMsTo3var
*******************************************************************************/
/**
 * @brief Converting ms to hours, minutes and seconds.
 * 
 * @param[in] timeInMs    Time in Ms to covert.
 * @param[in] hours       Hours in human format.
 * @param[in] minutes     Minutes in human format.
 * @param[in] seconds     Seconds in human format.
 * @return void
 * 
*******************************************************************************/
void convertMsTo3var(const msTimeT* const timeInMs,
                     humanTimeT* hours,
                     humanTimeT* minutes,
                     humanTimeT* seconds)
{
    *hours = (*timeInMs / HOURS_IN_MS);
    *minutes = (*timeInMs - (*hours * HOURS_IN_MS)) / MINUTES_IN_MS;
    *seconds = (*timeInMs - (*hours * HOURS_IN_MS) - (*minutes * MINUTES_IN_MS)) / SECONDS_IN_MS;
}


/* > Function printBoolOption
*******************************************************************************/
/**
 * @brief Printing boolean status of option on lcd.
 * 
 * @param[in] option        Status to modify
 * @return void
 * 
*******************************************************************************/
void printBoolOption(const bool* const option)
{
    lcd.setCursor(BOOL_OPTION_CURSOR_POS,1);
    if(*option == true)
    {
        lcd.print("TAK");
    }
    else
    {
        lcd.print("NIE");
    }
}

/* > Function printValueOption
*******************************************************************************/
/**
 * @brief Printing value status of option on lcd.
 * 
 * @param[in] value        Status to modify
 * @return void
 * 
*******************************************************************************/
void printValueOption(const int* const value, bool spaceFill)
{
    lcd.setCursor(UINT_OPTION_CURSOR_POS, 1); // TODO change this and desc
    char valueToPrint[10] = "";
    if(spaceFill)
    {
      snprintf(valueToPrint, sizeof valueToPrint, "% 5d", *value);
    }
    else
    {
      snprintf(valueToPrint, sizeof valueToPrint, "%05d", *value);   
    }
    lcd.print(valueToPrint);
}

/* > Function setBombGamemodeDomination
*******************************************************************************/
/**
 * @brief Setting default values to bomb gamemode options
 * 
 * @param[in] gamemodeBombS     Pointer to domination gamemode settings structure
 * @return void
 * 
*******************************************************************************/
void setDefaultGamemodeBomb(gamemodeBombS* gm)
{
    gm->gameTime = (0 * HOURS_IN_MS + 30 * MINUTES_IN_MS + 0 * SECONDS_IN_MS);
    gm->explosionTime = (0 * HOURS_IN_MS + 1 * MINUTES_IN_MS + 20 * SECONDS_IN_MS);
    gm->armingTime = (0 * HOURS_IN_MS + 0 * MINUTES_IN_MS + 1 * SECONDS_IN_MS);
    gm->defusingTime = (0 * HOURS_IN_MS + 0 * MINUTES_IN_MS + 1 * SECONDS_IN_MS);
    gm->enableSwitch = true;
    gm->slowReversing = false;
    gm->alarmSpeaker = (0 * HOURS_IN_MS + 0 * MINUTES_IN_MS + 30 * SECONDS_IN_MS);
    gm->delayStart = (0 * HOURS_IN_MS + 0 * MINUTES_IN_MS + 15 * SECONDS_IN_MS);
    
    gm->isDefuseEndGame = false;
    gm->explosionTimeReset = false;

    memset(&gm->history, 
           0,
           sizeof(gm->history));
}

/* > Function setDefaultGamemodeDomination
*******************************************************************************/
/**
 * @brief Setting default values to domination gamemode options
 * 
 * @param[in] gamemodeBombS     Pointer to domination gamemode settings structure
 * @return void
 * 
*******************************************************************************/
void setDefaultGamemodeDomination(gamemodeDominationS* gm)
{
    gm->gameTime = (1 * HOURS_IN_MS + 30 * MINUTES_IN_MS + 0 * SECONDS_IN_MS);
    gm->fullTakeOverTime = (0 * HOURS_IN_MS + 0 * MINUTES_IN_MS + 30 * SECONDS_IN_MS);
    gm->takeOverTime = (0 * HOURS_IN_MS + 0 * MINUTES_IN_MS + 5 * SECONDS_IN_MS);
    gm->pointTime = (0 * HOURS_IN_MS + 1 * MINUTES_IN_MS + 0 * SECONDS_IN_MS);
    gm->enableSwitch = false;
    gm->alarmSpeaker = (0 * HOURS_IN_MS + 0 * MINUTES_IN_MS + 30 * SECONDS_IN_MS);
    gm->winningPointsLimit = 61;
    gm->delayStart = (0 * HOURS_IN_MS + 0 * MINUTES_IN_MS + 0 * SECONDS_IN_MS);
    gm->pressButtonToStartGame = true;

    memset(&gm->history, 
           0,
           sizeof(gm->history));
}

/* > Function initializeMenu
*******************************************************************************/
/**
 * @brief Initializing and setting default values to menu and gamemode settings
 * 
 * @param[in] menuBaseS     Pointer to base menu structure.
 * @return void
 * 
*******************************************************************************/
void initializeMenu(menuBaseS* menuBase)
{   
    memset(&menuBase->navigation.menuPosition[0], 
           0,
           MENU_STAGES * sizeof(menuBase->navigation.menuPosition[0]));

    setDefaultGamemodeBomb(&menuBase->gamemodeData.gamemodeBomb);
    setDefaultGamemodeDomination(&menuBase->gamemodeData.gamemodeDomination);
    menuBase->navigation.freezeMenu = 0;
    printMenu(menuBase);
}

/* > Function printBombOptions
*******************************************************************************/
/**
 * @brief Printing to LCD screen current bomb gamemode options.
 * 
 * @param[in] menuBaseS     Pointer to structure with menu and gamemodes data.
 * @return void
 * 
*******************************************************************************/
void printBombOptions(const menuBaseS* const menuBase)
{       
        unsigned short position = menuBase->navigation.menuPosition[1];
        lcd.print((String)(menuBase->navigation.menuPosition[1] + 1) + 
                    ". ");
                    //menuBase->menuStrings.stringBomb[position]);
        lcd.setCursor(0,1);
        switch (position)
        {
        case 0:
            printTime(&menuBase->gamemodeData.gamemodeBomb.gameTime, false);
            lcd.setCursor(3,0);
            lcd.print("CZAS GRY");
            break;
        case 1:
            printTime(&menuBase->gamemodeData.gamemodeBomb.explosionTime, true);
            lcd.setCursor(3,0);
            lcd.print("CZAS WYBUCHU");
            break;
        case 2:
            printTime(&menuBase->gamemodeData.gamemodeBomb.armingTime, true);
            lcd.setCursor(3,0);
            lcd.print("UZBRAJANIE");
            break;
        case 3:
            printTime(&menuBase->gamemodeData.gamemodeBomb.defusingTime, true);
            lcd.setCursor(3,0);
            lcd.print("ROZBRAJANIE");
            break;
        case 4:
            printTime(&menuBase->gamemodeData.gamemodeBomb.delayStart, true);
            lcd.setCursor(3,0);
            lcd.print("OPOZN. START");
          break;
        case 5:
            printBoolOption(&menuBase->gamemodeData.gamemodeBomb.enableSwitch);
            lcd.setCursor(3,0);
            lcd.print("PRZELACZNIK");
            break;
        case 6:
            printBoolOption(&menuBase->gamemodeData.gamemodeBomb.isDefuseEndGame);
            lcd.setCursor(3,0);
            lcd.print("ROZ. KONCZY");
            break;
        case 7:
            printBoolOption(&menuBase->gamemodeData.gamemodeBomb.explosionTimeReset);
            lcd.setCursor(3,0);
            lcd.print("RES.CZAS.EKS");
            break;
        case 8:
            printBoolOption(&menuBase->gamemodeData.gamemodeBomb.slowReversing);
            lcd.setCursor(3,0);
            lcd.print("COFANIE PROG.");
            break;
        case 9:
            printTime(&menuBase->gamemodeData.gamemodeDomination.alarmSpeaker, false);
            lcd.setCursor(3,0);
            lcd.print("SYRENA");
            break;
        case 10:
            lcd.setCursor(3,0);
            lcd.print("HISTORIA");
            break;
        case 11:
            lcd.setCursor(3,0);
            lcd.print("START");
            break;
        default:
            break;
        }
}

/* > Function printDominationOptions
*******************************************************************************/
/**
 * @brief Printing to LCD screen current domination gamemode options.
 * 
 * @param[in] menuBaseS     Pointer to structure with menu and gamemodes data.
 * @return void
 * 
*******************************************************************************/
void printDominationOptions(const menuBaseS* const menuBase)
{       
        unsigned short position = menuBase->navigation.menuPosition[1];

        lcd.print((String)(menuBase->navigation.menuPosition[1] + 1) + 
                    ". ");//+ 
                    //menuBase->menuStrings.stringDomination[position]);
        lcd.setCursor(0,1);
        switch (position)
        {
        case 0:
            printTime(&menuBase->gamemodeData.gamemodeDomination.gameTime, false);
            lcd.setCursor(3,0);
            lcd.print("CZAS GRY");
            break;
        case 1:
            printTime(&menuBase->gamemodeData.gamemodeDomination.fullTakeOverTime, true);
            lcd.setCursor(3,0);
            lcd.print("P. PRZEJECIE");
            break;
        case 2:
            printTime(&menuBase->gamemodeData.gamemodeDomination.takeOverTime, true);
            lcd.setCursor(3,0);
            lcd.print("PRZEJECIE");
            break;
        case 3:
            printTime(&menuBase->gamemodeData.gamemodeDomination.pointTime, true);
            lcd.setCursor(3,0);
            lcd.print("PUNKT CO");
            break;
        case 4:
            printValueOption(&menuBase->gamemodeData.gamemodeDomination.winningPointsLimit, true); // TODO think about that, and about move it ot common
            lcd.setCursor(3,0);
            lcd.print("LIMIT PUNKOW");
            break;
        case 5:
            printBoolOption(&menuBase->gamemodeData.gamemodeDomination.pressButtonToStartGame);
            lcd.setCursor(3,0);
            lcd.print("PRZYC. START");
          break;
        case 6:
            printTime(&menuBase->gamemodeData.gamemodeDomination.delayStart, true);
            lcd.setCursor(3,0);
            lcd.print("OPOZN. START");
            break;
        case 7:
            printBoolOption(&menuBase->gamemodeData.gamemodeDomination.enableSwitch);
            lcd.setCursor(3,0);
            lcd.print("PRZELACZNIK");
            break;
        case 8:
            printTime(&menuBase->gamemodeData.gamemodeDomination.alarmSpeaker, false);
            lcd.setCursor(3,0);
            lcd.print("SYRENA");
            break;
        case 9:
            lcd.setCursor(3,0);
            lcd.print("HISTORIA");
            break;
        case 10:
            lcd.setCursor(3,0);
            lcd.print("START");
            break;
        default:
            break;
        }
}

/* > Function printMenuStage1
*******************************************************************************/
/**
 * @brief Printing to LCD screen current menu stage 1 option.
 * 
 * @param[in] menuNavigationS     Pointer to structure with menu navigation data.
 * @param[in] menuStringsS        Pointer to structure menu strings.
 * @return void
 * 
*******************************************************************************/
void printMenuStage1(const menuBaseS* const menuBase)
{   
    unsigned short positionStage0 = menuBase->navigation.menuPosition[0];
    unsigned short positionStage1 = menuBase->navigation.menuPosition[
        menuBase->navigation.menuStage];
        
    if(positionStage0 == BOMB_GAMEMODE)
    {
        printBombOptions(menuBase);
    }
    else if(positionStage0 == DOMINATION_GAMEMODE)
    {
        printDominationOptions(menuBase);
    }
}

/* > Function printMenuStage0
*******************************************************************************/
/**
 * @brief Printing to LCD screen current menu stage 0 option.
 * 
 * @param[in] menuNavigationS     Pointer to structure with menu navigation data.
 * @param[in] menuStringsS        Pointer to structure menu strings.
 * @return void
 * 
*******************************************************************************/
void printMenuStage0(const menuBaseS* const menuBase)
{   
    unsigned short position = menuBase->navigation.menuPosition[
        menuBase->navigation.menuStage];

    lcd.print((String)(position + 1) + 
            ". " + 
            menuBase->menuStrings.stringStage0[position]);
}

/* > Function printMenu
*******************************************************************************/
/**
 * @brief Printing to LCD screen current menu option
 * 
 * @param[in] menuNavigationS     Pointer to structure with menu navigation data.
 * @param[in] menuStringsS        Pointer to structure menu strings.
 * @return void
 * 
*******************************************************************************/
void printMenu(const menuBaseS* const menuBase)
{
    lcd.clear();
    lcd.setCursor(0, 0);
    if(menuBase->navigation.menuStage == 0)
    {
        printMenuStage0(menuBase);
    }
    if(menuBase->navigation.menuStage == 1)
    {
        printMenuStage1(menuBase);
    }
}

/* > Function validateStage0Position
*******************************************************************************/
/**
 * @brief Checks menu positions and wrap around if its needed.
 * 
 * @param[in] currentMenuPosition  Pointer to structure with menu 
 *                                 navigation data.
 * @return void
 * 
*******************************************************************************/
void validateStage0Position(unsigned short* currentMenuPosition)
{
    if (*currentMenuPosition == AMMOUNT_OF_GAMEMODES)
    {
        *currentMenuPosition = 0;
    }
    else if (*currentMenuPosition == 65535) //TODO change this
    {
        *currentMenuPosition = AMMOUNT_OF_GAMEMODES - 1;
    }
}

/* > Function validateStage1_1Position
*******************************************************************************/
/**
 * @brief Checks bomb gamemode menu positions and 
 *        wrap around if its needed.
 * 
 * @param[in] currentMenuPosition  Pointer to structure with menu 
 *                                 navigation data.
 * @return void
 * 
*******************************************************************************/
void validateStage1_1Position(menuBaseS* menuBase)
{
  //gamemodeBombS gm = menuBase->gamemodeData.gamemodeBomb;
  if(menuBase->navigation.menuStage == 2)
  {
    if(menuBase->navigation.menuPosition[2] > STAGE_1_1_OPTIONS)
    {
      menuBase->navigation.menuPosition[2] = STAGE_1_1_OPTIONS;
    } //TODO

    switch (menuBase->navigation.menuPosition[1])
    {
      case 0:
        setTime(&menuBase->gamemodeData.gamemodeBomb.gameTime, false);

        //if(menuBase->gamemodeData.gamemodeBomb.explosionTime > menuBase->gamemodeData.gamemodeBomb.gameTime) menuBase->gamemodeData.gamemodeBomb.explosionTime = menuBase->gamemodeData.gamemodeBomb.gameTime;
        //if(menuBase->gamemodeData.gamemodeBomb.armingTime > menuBase->gamemodeData.gamemodeBomb.gameTime) menuBase->gamemodeData.gamemodeBomb.armingTime = menuBase->gamemodeData.gamemodeBomb.gameTime;
        //if(menuBase->gamemodeData.gamemodeBomb.defusingTime > menuBase->gamemodeData.gamemodeBomb.gameTime) menuBase->gamemodeData.gamemodeBomb.defusingTime = menuBase->gamemodeData.gamemodeBomb.gameTime;

        break;
      case 1:

        setTime(&menuBase->gamemodeData.gamemodeBomb.explosionTime, true);
        break;

      case 2:

        setTime(&menuBase->gamemodeData.gamemodeBomb.armingTime, true);
        if(menuBase->gamemodeData.gamemodeBomb.armingTime == 0) menuBase->gamemodeData.gamemodeBomb.armingTime = 10;
        break;

      case 3:

        setTime(&menuBase->gamemodeData.gamemodeBomb.defusingTime, true);
        if(menuBase->gamemodeData.gamemodeBomb.defusingTime == 0) menuBase->gamemodeData.gamemodeBomb.defusingTime = 10;
        break;
      case 4:
        setTime(&menuBase->gamemodeData.gamemodeBomb.delayStart, true);
        break;
      case 5:
        setBoolean(&menuBase->gamemodeData.gamemodeBomb.enableSwitch);
        break;
      case 6:
        setBoolean(&menuBase->gamemodeData.gamemodeBomb.isDefuseEndGame);
        break;
      case 7:
        setBoolean(&menuBase->gamemodeData.gamemodeBomb.explosionTimeReset);
        break;
      case 8:
        setBoolean(&menuBase->gamemodeData.gamemodeBomb.slowReversing);
        break;
      case 9:
        setTime(&menuBase->gamemodeData.gamemodeBomb.alarmSpeaker, true, ALARM_SPEAKER_MAX_TIME);
        break;
      case 10:
        printBombHisotry(menuBase->gamemodeData.gamemodeBomb.history);
        break;
      case 11:
        startGame(menuBase);
        break;    
      default:
        break;
    }
    //memcpy(&menuBase->gamemodeData.gamemodeBomb, &gm, sizeof(gm));
    //menuBase->gamemodeData.gamemodeBomb = gm;
  }
  else
  {
    if (menuBase->navigation.menuPosition[1] == STAGE_1_1_OPTIONS)
    {
        menuBase->navigation.menuPosition[1] = 0;
    }
    else if (menuBase->navigation.menuPosition[1] == 65535) //TODO change this
    {
        menuBase->navigation.menuPosition[1] = STAGE_1_1_OPTIONS - 1;
    }
  }
}

/* > Function validateStage1_2Position
*******************************************************************************/
/**
 * @brief Checks domination gamemode menu positions and
 *        wrap around if its needed.
 * 
 * @param[in] currentMenuPosition  Pointer to structure with menu 
 *                                 navigation data.
 * @return void
 * 
*******************************************************************************/
void validateStage1_2Position(menuBaseS* menuBase)
{
    if(menuBase->navigation.menuStage == 2)
    {
        if(menuBase->navigation.menuPosition[2] > STAGE_1_2_OPTIONS)
        {
            menuBase->navigation.menuPosition[2] = STAGE_1_2_OPTIONS;
        } //TODO
        switch (menuBase->navigation.menuPosition[1])
        {
        case 0: // gameTime
            setTime(&menuBase->gamemodeData.gamemodeDomination.gameTime, false);
            // Zero case -> 1 sec
            (menuBase->gamemodeData.gamemodeDomination.pointTime == 0) ? menuBase->gamemodeData.gamemodeDomination.pointTime = SECONDS_IN_MS : menuBase->gamemodeData.gamemodeDomination.pointTime;

            // Pointing time > gameTime
            if((menuBase->gamemodeData.gamemodeDomination.pointTime >
                  menuBase->gamemodeData.gamemodeDomination.gameTime) && 
               (menuBase->gamemodeData.gamemodeDomination.gameTime != 0))
            {
              menuBase->gamemodeData.gamemodeDomination.pointTime = 
                menuBase->gamemodeData.gamemodeDomination.gameTime;
            }     
            break;
        case 1: // fullTakeOverTime
            setTime(&menuBase->gamemodeData.gamemodeDomination.fullTakeOverTime, true);
            if(menuBase->gamemodeData.gamemodeDomination.fullTakeOverTime == 0)
            {
              menuBase->gamemodeData.gamemodeDomination.fullTakeOverTime = 8;
            }
       
            // takeOverTime > fullTakeOverTime
            if(menuBase->gamemodeData.gamemodeDomination.takeOverTime >
               menuBase->gamemodeData.gamemodeDomination.fullTakeOverTime)
            {
              menuBase->gamemodeData.gamemodeDomination.takeOverTime = 
                menuBase->gamemodeData.gamemodeDomination.fullTakeOverTime;
            }
            break;
        case 2: // takeOverTime
            setTime(&menuBase->gamemodeData.gamemodeDomination.takeOverTime, true, menuBase->gamemodeData.gamemodeDomination.fullTakeOverTime); // case with limit
            if(menuBase->gamemodeData.gamemodeDomination.takeOverTime == 0)
            {
              menuBase->gamemodeData.gamemodeDomination.takeOverTime = 8;
            }
            break;
        case 3: // pointTime
            if(menuBase->gamemodeData.gamemodeDomination.gameTime == 0)
            {
              setTime(&menuBase->gamemodeData.gamemodeDomination.pointTime, true, HOURS_IN_MS); // case with limit
            }
            else
            {
              setTime(&menuBase->gamemodeData.gamemodeDomination.pointTime, true, menuBase->gamemodeData.gamemodeDomination.gameTime);
            }
            // Zero case -> 1sec
            // TODO: fix this
            (menuBase->gamemodeData.gamemodeDomination.pointTime == 0) ? menuBase->gamemodeData.gamemodeDomination.pointTime = SECONDS_IN_MS : menuBase->gamemodeData.gamemodeDomination.pointTime;
            break;
        case 4: // winning points limit
            setValue(&menuBase->gamemodeData.gamemodeDomination.winningPointsLimit, 30000);
            if(menuBase->gamemodeData.gamemodeDomination.winningPointsLimit == 0)
            {
              menuBase->gamemodeData.gamemodeDomination.winningPointsLimit = 30000;
            }
            break;
        case 5:
            setBoolean(&menuBase->gamemodeData.gamemodeDomination.pressButtonToStartGame);
            if(menuBase->gamemodeData.gamemodeDomination.pressButtonToStartGame)
            {
              menuBase->gamemodeData.gamemodeDomination.delayStart = 0;
            }
            break;
        case 6:
            setTime(&menuBase->gamemodeData.gamemodeDomination.delayStart, true);
            if(menuBase->gamemodeData.gamemodeDomination.delayStart)
            {
              menuBase->gamemodeData.gamemodeDomination.pressButtonToStartGame = false;
            }
            break;
        case 7: // switch
            setBoolean(&menuBase->gamemodeData.gamemodeDomination.enableSwitch);
            break;
        case 8: // alarm Speaker
            setTime(&menuBase->gamemodeData.gamemodeDomination.alarmSpeaker, true, ALARM_SPEAKER_MAX_TIME);
            break;
        case 9:
            printDominationHisotry(menuBase->gamemodeData.gamemodeDomination.history);
            break;
        case 10:
            startGame(menuBase);
            break;
        default:
            break;
        }
    }
    else
    {
        if (menuBase->navigation.menuPosition[1] == STAGE_1_2_OPTIONS)
        {
            menuBase->navigation.menuPosition[1] = 0;
        }
        else if (menuBase->navigation.menuPosition[1] == 65535) //TODO change this
        {
            menuBase->navigation.menuPosition[1] = STAGE_1_2_OPTIONS - 1;
        }
    }
}

/* > Function validateMenuPositionWrapper
*******************************************************************************/
/**
 * @brief Wrapper for menu position cheecker and wrap around position 
 *        if its needed.
 *        
 * @param[in] menuNavigationS  Pointer to structure with menu navigation data.
 * @return void
 * 
*******************************************************************************/
void validateMenuPositionWrapper(menuBaseS* menuBase)
{   
    unsigned short stage = menuBase->navigation.menuStage;
    if (stage == 0)
    { 
        validateStage0Position(&menuBase->navigation.menuPosition[0]);
        menuBase->navigation.menuPosition[1] = 0;
    }
    else if (stage == 1 || stage == 2)
    {
        if (menuBase->navigation.menuPosition[0] == 0)
        {
            validateStage1_1Position(menuBase);
            menuBase->navigation.menuStage = 1;
        }
        else if(menuBase->navigation.menuPosition[0] == 1)
        {
            validateStage1_2Position(menuBase);
            menuBase->navigation.menuStage = 1;
        }
    }
    if (stage == MENU_STAGES)
    {
        menuBase->navigation.menuStage = MENU_STAGES - 1;
    }
    else if (stage == 65535)
    {
        menuBase->navigation.menuStage = 0;        
    }
}

/* > Function processMenu
*******************************************************************************/
/**
 * @brief Create menu variables and structures and run main menu loop.
 *        
 * @return void
 * 
*******************************************************************************/
void processMenu()
{

    menuBaseS menuBase;


    initializeMenu(&menuBase);
    bool isButtonPushed = false;

    //DEBUG
    //printGamemodeSettingsOnSerial(&menuBase.gamemodeData.gamemodeDomination);
    //processDomination(&menuBase.gamemodeData.gamemodeDomination);
    //processBomb(&menuBase.gamemodeData.gamemodeBomb);
    //initializeMenu(&menuBase);
    //DEBUG

    while(true)
    {   
        isButtonPushed = false;

        if (buttonPushed(RIGHT_BUTTON))
        {
            //Serial.println("right");
            isButtonPushed = true;
            menuBase.navigation.menuPosition[menuBase.navigation.menuStage]++;
        }
        if (buttonPushed(LEFT_BUTTON))
        {
            //Serial.println("left");
            isButtonPushed = true;
            menuBase.navigation.menuPosition[menuBase.navigation.menuStage]--;
        }
        if (buttonPushed(DOWN_BUTTON))
        {
            //Serial.println("down");
            isButtonPushed = true;
            menuBase.navigation.menuStage++;
            //menuBase.navigation.menuPosition[menuBase.navigation.menuStage] = 0;
        }
        if (buttonPushed(UP_BUTTON))
        {
            //Serial.println("up");
            isButtonPushed = true;
            menuBase.navigation.menuStage--;
        }

        if(isButtonPushed)
        {
            validateMenuPositionWrapper(&menuBase);
            printMenu(&menuBase);
            //printGamemodeSettingsOnSerial(&menuBase.gamemodeData.gamemodeDomination);
        }
        if(menuBase.navigation.freezeMenu)
        {
          waitUntilButtonReleased();
          menuBase.navigation.freezeMenu = false;
        }
    }
}
