wiktorCzechowski8127/MilitaryGamesTimer/code/MilitaryGamesTimer/gamemodeCommon.ino

#include "gamemodeCommon.hpp"

/* > Function initializeTiming
*******************************************************************************/
/**
 * @brief Filling timing structure.
 * 
 * @param[in] timeInMs      Time in Ms to print.
 * @param[in] minutesOlny   Printing time without hours.
 * @return void
 * 
*******************************************************************************/
void initializeTiming(gamemodeTiming* timing,
                      const unsigned long* const gametime,
                      const msTimeT* const alarmSpeakerTime,
                      const msTimeT delayAlarmStop)
{
  memset(timing, 0, sizeof(gamemodeTiming));

  timing->isGameRunning = true;
  timing->currentTime = millis();

  if(*gametime == 0)
  {
    timing->isUnlimitedTime = true;
    timing->endgame = timing->currentTime;
  }
  else
  {
    timing->isUnlimitedTime = false;
    timing->endgame = timing->currentTime + *gametime;
  }

  timing->timeLeft = 0;
  timing->lastCurrentTime = timing->currentTime;
  timing->alarmSpeakerEnd = *alarmSpeakerTime;
  timing->delayAlarmStop = delayAlarmStop;
  //DEBUG
  /*
  Serial.println("");
  Serial.println("GAMEMODE");    
  Serial.println("endgame: " + (String)timing->endgame);
  Serial.println("timeLeft: " + (String)timing->timeLeft);
  Serial.println("currentTime: " + (String)timing->currentTime);
  Serial.println("lastCurrentTime: " + (String)timing->lastCurrentTime);
  Serial.println("alarmSpeakerEnd: " + (String)timing->alarmSpeakerEnd);
  Serial.println("isUnlimitedTime: " + (String)timing->isUnlimitedTime);
  Serial.println("turnSpeakerAlarmOn: " + (String)timing->turnSpeakerAlarmOn);
  Serial.println("invertTime: " + (String)timing->invertTime);
  */
}

/* > Function valideateEndGameOrPrintTimeLeft
*******************************************************************************/
/**
 * @brief Checking end game conditions and if none of them is true calculating
 *        and printing on lcd time left.
 * 
 * @param[in] timing      Pointer to gamemodeTiming structure.
 *
 * @return void
 * 
*******************************************************************************/
bool valideateEndGameOrPrintTimeLeft(gamemodeTiming* timing)
{
  bool isGameRunning = true;

  if(timing->currentTime > timing->endgame &&
     timing->invertTime == false)
  {
    isGameRunning = false;
    timing->timeLeft = 0;
    timing->turnSpeakerAlarmOn = true;
  }
  else
  {
    if(timing->invertTime == true)
    {
      // When invertTime == true this parameter calculate time elapsed since the start.
      timing->timeLeft = timing->currentTime - timing->endgame;
    }
    else
    {
      timing->timeLeft = timing->endgame - timing->currentTime;
    }
    printTime(&timing->timeLeft, false);

    if(timing->currentTime > timing->delayAlarmStop)
    {
      digitalWrite(RELAY, RELAY_OFF);
    }
    //Serial.println(timing->timeLeft); //DEBUG
  }
  return isGameRunning;
}

/* > Function checkGameInterrupt
*******************************************************************************/
/**
 * @brief Checking whether left and right menu buttons are pushed. If buttons are
 *        pushed longer than 2 seconds game end. 
 * 
 * @param[in] timing      Pointer to gamemodeTiming structure.
 *
 * @return bool
 * 
*******************************************************************************/
bool checkGameInterrupt(gamemodeTiming* timing)
{
  if (timing->isGameRunning == true) 
  {
    timing->endButtonsKeepPushed = false;

    // buttons pushing check.
    if (!digitalRead(LEFT_BUTTON) && !digitalRead(RIGHT_BUTTON))
    {
      timing->endButtonsKeepPushed = true;

      if (timing->buttonPushingTime == 0) 
      {
        timing->buttonPushingTime = timing->currentTime;
      }
    }

    // Pressing buttons continuously.
    if (timing->endButtonsKeepPushed == true) 
    {
      if (timing->currentTime > (timing->buttonPushingTime + INTERRUPT_TIME))
      {
        timing->isGameRunning = false;
        timing->turnSpeakerAlarmOn = false;
        digitalWrite(RELAY, RELAY_OFF);
        return true;
      }
    } 
    else
    {
      timing->buttonPushingTime = 0;
    }
  }
  return false;
}

/* > Function processGameSummary
*******************************************************************************/
/**
 * @brief   Controlling the speaker alarm and processing buttons that allow 
 *          to leave the game summary and go to the menu.
 * 
 * @param[in] timing      Pointer to gamemodeTiming structure.
 *
 * @return void
 * 
*******************************************************************************/
void processGameSummary(gamemodeTiming* timing)
{
  if(timing->turnSpeakerAlarmOn)
  {
    timing->alarmSpeakerEnd = timing->alarmSpeakerEnd + millis();
    digitalWrite(RELAY, RELAY_ON);
  }

  uint8_t endButtonKeepPushed = false;
  msTimeT pushingTime = 0;
  waitUntilButtonReleased();

  while (true)
  {
    timing->currentTime = millis();
    endButtonKeepPushed = false;

    // TODO: try to move this to function.
    if (!digitalRead(LEFT_BUTTON) && !digitalRead(RIGHT_BUTTON))
    {
      endButtonKeepPushed = true;

      if (pushingTime == 0)
      {
        pushingTime = timing->currentTime;
      }
    }

    if (endButtonKeepPushed == true)
    {
      if (timing->currentTime > (pushingTime + INTERRUPT_TIME))
      {

        // turning off speaker alarm if it works.
        if (timing->turnSpeakerAlarmOn == true) 
        {
          digitalWrite(RELAY, RELAY_OFF);
          pushingTime = 0;
          timing->turnSpeakerAlarmOn = false;
          waitUntilButtonReleased();
        } 
        else
        {
          break;
        }
      }
    } 
    else
    {
      pushingTime = 0;
    }

    // checking if it's time to turn off the siren
    if ((timing->currentTime > timing->alarmSpeakerEnd) && (timing->turnSpeakerAlarmOn == true))
    {
      digitalWrite(RELAY, RELAY_OFF);
      timing->alarmSpeakerEnd = 0;
      timing->turnSpeakerAlarmOn = false;
    }
    //Serial.println("MILLIS: " + String(millis()) + " ALARM SPEAKER END " + String(timing.alarmSpeakerEnd));
  }
}


/* > Function delayStart
*******************************************************************************/
/**
 * @brief Processing delay start time
 * 
 * @return void
 * 
*******************************************************************************/
msTimeT delayStart(const msTimeT delayTime)
{
  bool stopedByInterrupt = false;
  msTimeT alarm = 0;
  if(delayTime != 0)
  {
    gamemodeTiming timing;
    initializeTiming(&timing, &delayTime, &alarm, 0);
    while(timing.isGameRunning)
    {
      timing.currentTime = millis();

      if(timing.isGameRunning)
      {
        lcd.setCursor(4,0);
        lcd.print("START ZA");
        lcd.setCursor(4,1);
        timing.isGameRunning = valideateEndGameOrPrintTimeLeft(&timing);
        stopedByInterrupt = checkGameInterrupt(&timing);
      }
    }

    if(stopedByInterrupt)
    {
      digitalWrite(RELAY, RELAY_OFF);
      return 0;
    }
    else
    {
      digitalWrite(RELAY, RELAY_ON);
      return timing.currentTime + (30 * SECONDS_IN_MS);
    }
  }
  return 0;
}
