wiktorCzechowski8127/MilitaryGamesTimer/(commit log)

2024-02-08 Very first commit
    Prototype of counting system
    Prototype of progress bar
2024-02-19 Menu - fully work
    - settign default values
    - setting time option
    - setting boolean option
    - printing parametes and menu stages
    - time conversion functons
2024-02-20 Includes cleanup
    - Unnesesery includes deleted, used includes move to correct place.
    - externals moved to .h files.
    - .h files structure cleanup.
    - calling domination gamemode form menu level.
    - small fixes.
    [MilitaryGamesTimer.ino, buttons.hpp, common.hpp, common.ino, domination.hpp, domination.ino, gamemodeCommon.hpp, gamemodeCommon.ino]
2024-02-27 Domination Gamemode - buttons usage
    Added buttons usage to domination gamemode
    Calculationg PointsInMS
    Tresholds for pointsInMS added
2024-03-01 progressBar basic funcionality
    - Initializing 2 zones porgress bar
    - printing 2 zones progress bar
    - progress bar implemented into domination gamemode
2024-03-05 domination gamemode - update
    - ending screen added
    - printing winning points
2024-03-11 Domination gamemode in progress
    - switch added
    - winning team marker added
    - 2_TEAMS progress bar finished
2024-03-12 End of Domination Gamemoed
    Returning to menu
    Printing ingame points
    printing summary points
2024-03-14 Domination gamemode
    Gamemode domination finished
    - buzzer funcionality added
    - alarm speaker funcionality added
    - winning points limit ending added
    - value option choose in menu added
    - endgame conditions
    [MilitaryGamesTimer.ino, buttons.hpp, common.hpp, common.ino, domination.hpp, domination.ino, gamemodeCommon.hpp, gamemodeCommon.ino]
2024-03-21 String structure error Fix
    Don't know why, adding new values to structure with menu strings generates lots of unpredictable errors. Despite of checking code, i couldn't find source of error, so I decide delete this structure and paste strings into menu printing function. This change fixed all errors. In future all menu functions should be refactored.
    [bomb.hpp, bomb.ino, domination.ino, menu.hpp, menu.ino]
2024-03-28 game history
    - game history that can kep result of last 3 games of each gamemode.
    - small fixed
    program memory 73%
    data memory 68%
    [bomb.hpp, bomb.ino, domination.hpp, domination.ino, gamemodeCommon.hpp, gamemodeCommon.ino, menu.hpp, menu.ino]
2024-04-08 progress bar refactor + led added
    New progressBar class
    Refactored progressBar functions
    New led class
2024-04-08 relay work mode added
    Added mechanism to choose relay work mode.
2024-04-12 Refactors
    Domination gamemode cleanup
    buttons.hpp rename to gpio.hpp
    FREEZE define deleted and new function waitUntilButtonReleased added
    some small fixes
    [MilitaryGamesTimer.ino, bar.cpp, bar.hpp, bomb.hpp, bomb.ino, common.hpp, common.ino, domination.hpp]
2025-01-24 button press to start domination gamemode
    menu option that allows to start counting time left when any button was pushed. This option excludes delayed start.
2025-02-09 build fix
    - missing leds initialization in domination.ino added
    [domination.ino]
